ChrisTekam/thermobox/report/report.pdf

## Design and Implementation of an Arduino-Based

## Thermal PI Control System

## R. Khedoe, D. Sewratan, C. Tekam and D. Wartim

BSc. Electrical Engineering, FTeW, AdeKUS, Paramaribo, Suriname

## Abstract

Thermal control systems are widely used and have applications in semiconductor manufacturing and thermal power plants. However, thermal control systems are slow, limited by the actuator, and sensitive to disturbances. Recent work has attempted to solve these problems with PID simulations or complex algorithms. These approaches are valid, but quite complex. In contrast, this project regulates temperature inside a small foam box, utilizing MATLAB scripts and PI logic on Arduino. From the results, the setpoint is maintained, but the overshoot requirements are not achieved. The plant model cannot describe the system dynamics. Further analysis is needed to either tune the PI controller or accurately model the plant.

Index Terms - Thermal control, PI, MATLAB, Arduino

## I. Introduction

Thermal systems have many industrial applications, such as

semiconductor manufacturing and thermal power plants [1].

Therefore, thermal control is crucial for achieving accurate

measurements, maintaining production quality and optimizing

energy usage [2], [3]. However, thermal control systems also

face many challenges, such as disturbances, actuator limitations,

slow dynamics and delay [1], [4].

By designing a suitable controller, many of these issues are

addressed [4], [5]. For most (industrial) thermal processes,

Proportional Integral Derivative (PID) control is implemented,

but depending on the plant and objectives, PI control is sufficient

[5]. Previous studies implement PID thermal control only in

simulation or use a complex algorithm and plant, where Arduino

is exclusively used for data acquisition [6], [7], [8].

In contrast, this project aims to regulate the temperature at

a setpoint in a small foam box in both a Simulink model

and physical lab experiment. The closed-loop system uses an

Arduino Uno to implement PI-control and data acquisition, with

controller gains that are selected analytically. The design is

evaluated with frequency response theory (Nyquist and Bode) and tested on the physical system under disturbances. The

objective is to minimize the settling time and overshoot while

also rejecting disturbances.

## II. Methods

From the general block diagram for a control system (see fig. 1)

and the available components (see appendix A), design of the

system begins.

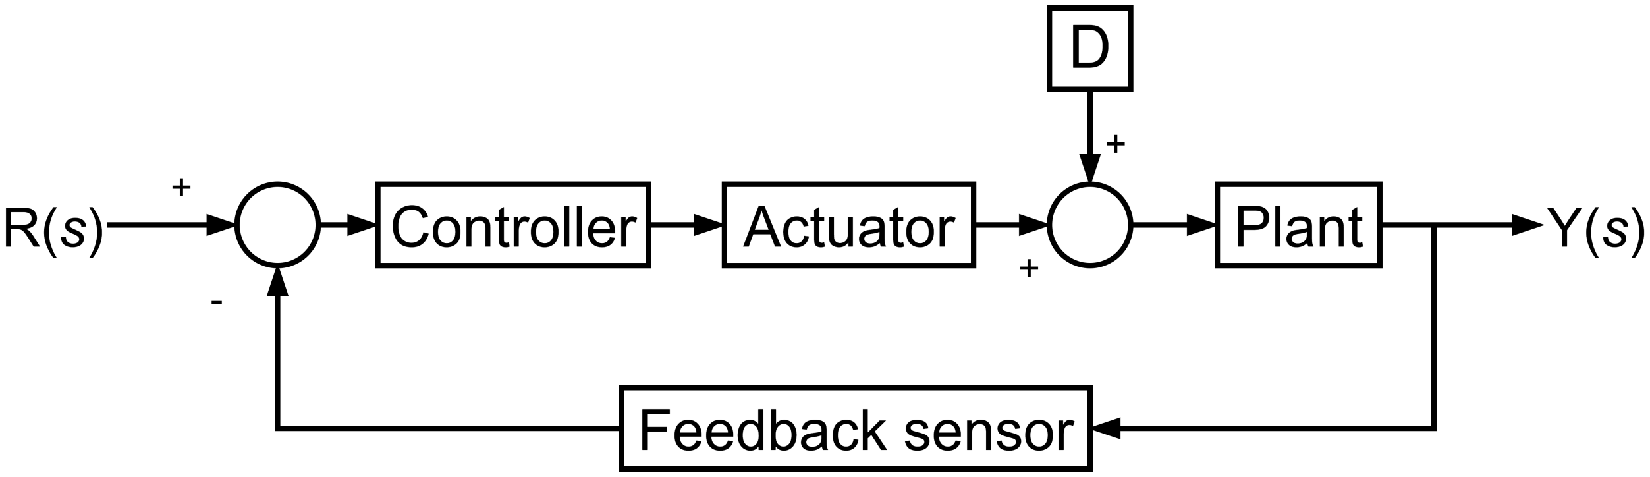
[picture p3: figure]

Figure 1: General block diagram for a control system.

The goals are to reduce settling time, overshoot and reject

disturbances; therefore it is necessary to choose and design

components appropriately (see table 1).

Table 1: System implementation.

Element | Implementation
Controller | PI logic on Arduino Uno
Actuator | Heater
Plant | Temperature inside the box
Feedback sensor | DS18B20 probe
Signal Conditioner Heater driver circuit

The heater system consists of the heater driver circuit and the

power resistor (see fig. B.1) and is located inside a small EPS

foam box. Assuming it is cube-shaped with an internal volume

of 500 mL, wall thickness t = 2 cm, and thermal conductivity κ = 0.033 W m⁻¹ K

−1
[10], the plant transfer function is

Gp (s) =

θ(s)

D(s)

=

V

2
s
R

Rth

RthCths + 1

=

96.7
283s + 1

(1)

See appendix C for the derivation.

The block diagram for the thermal control system is shown in

fig. 2.

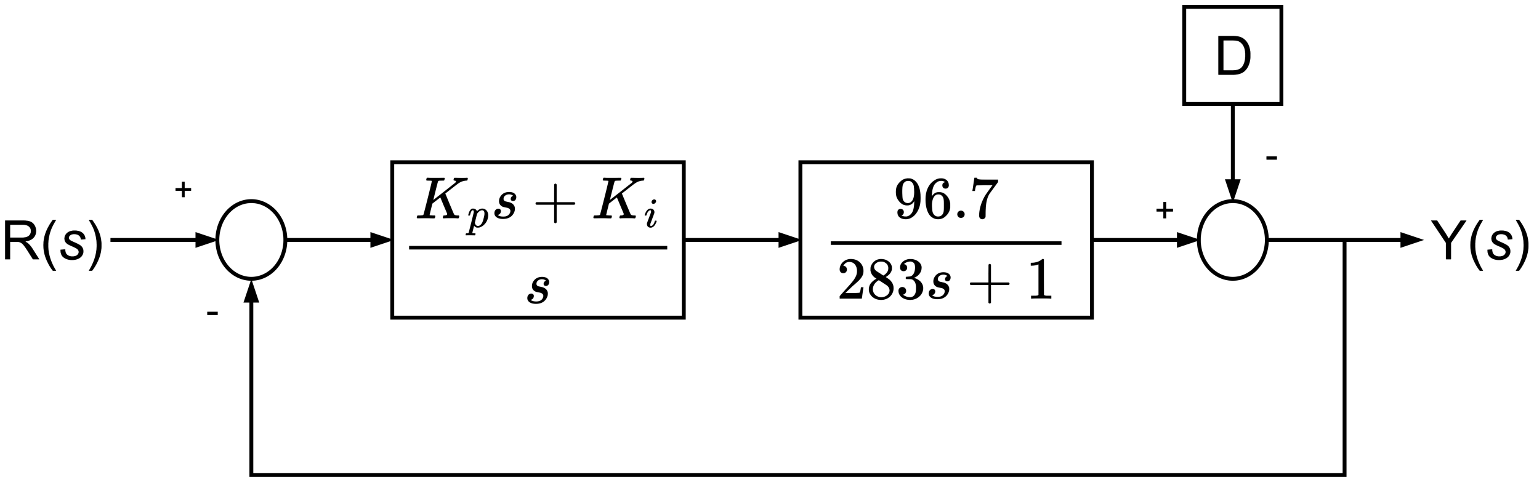
[picture p4: figure]

Figure 2: Thermal control system block diagram.

And this corresponds with

CLTF =

96.7(Kps + Ki)
283s

2 + (1 + 96.7Kp)s + 96.7Ki

=

0.342(Kps + Ki)

s

2 + (0.0035 + 0.342Kp)s + 0.342Ki

(2)

Utilizing MATLAB/Simulink and the frequency response the-

ory, system stability and performance is evaluated, before lab

tests begin. Figure 3 and 4 illustrate the Simulink model and

the system schematic diagram (in lab), respectively.

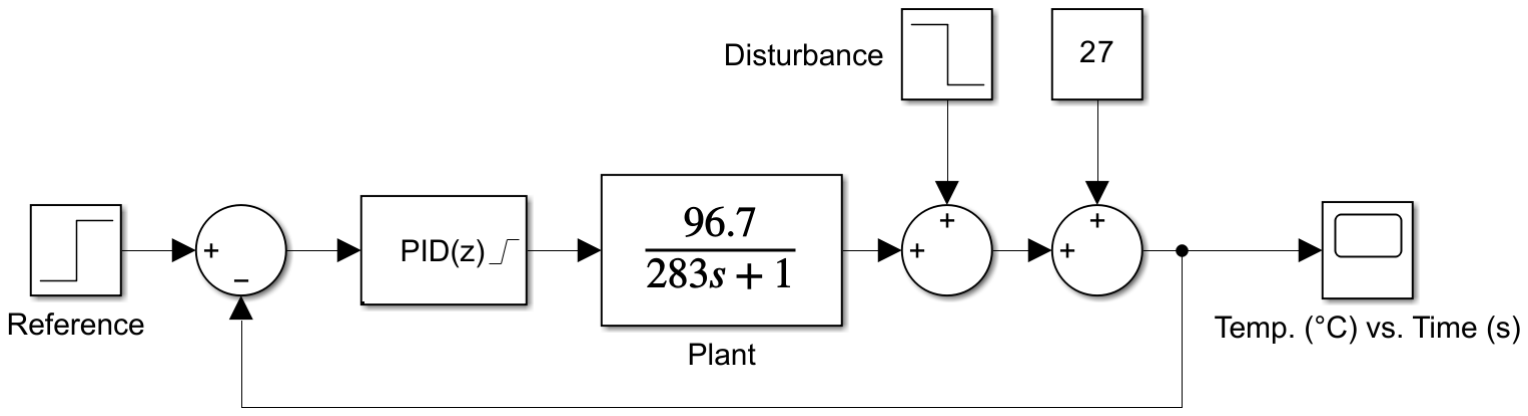
[picture p5: figure]

Figure 3: Simulink model.

The ‘27’ block adds an offset, ensuring the temperature rise starts

from the ambient temperature. Furthermore, unity feedback

is assumed, as the probe measures and responds much quicker

compared to the rise in the box [9].

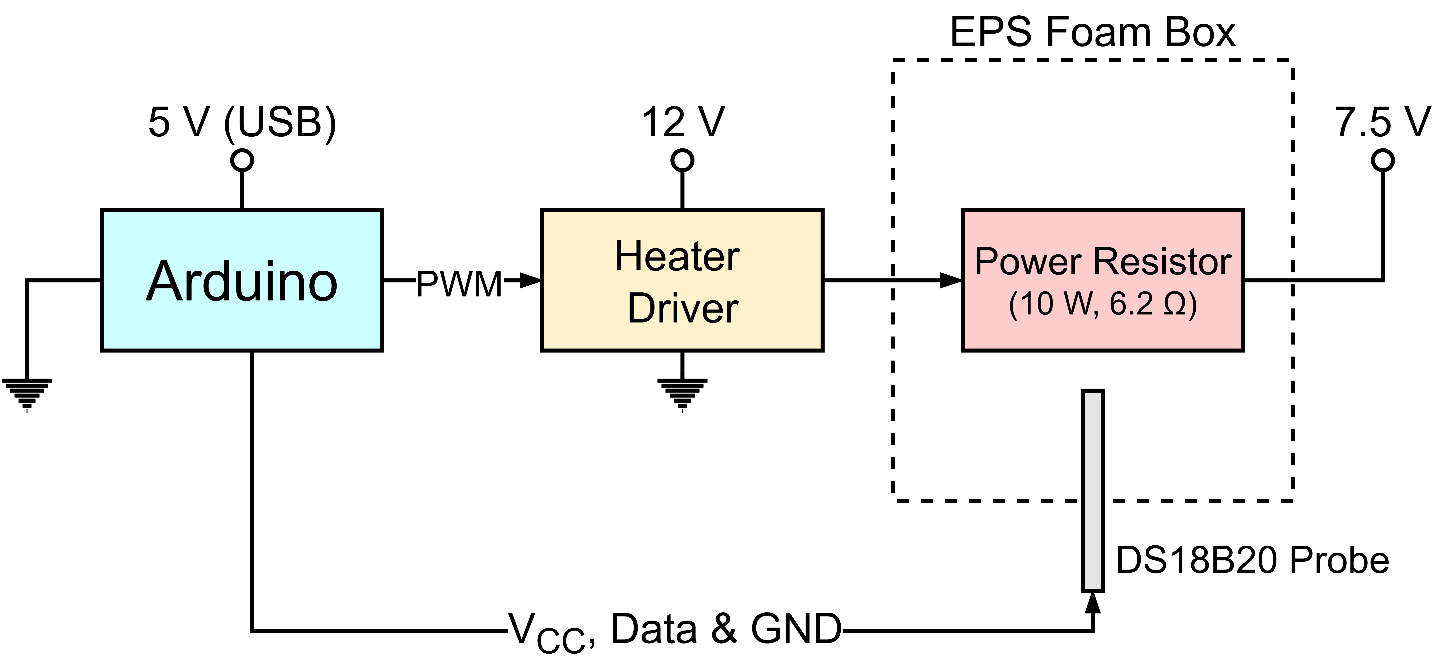
[picture p6: figure]

Figure 4: In lab system diagram.

By conducting open-loop tests in lab and making use of a

function fit script, the ‘real’ plant transfer function can be

approximated. Furthermore, closed-loop tests can reveal the

effectiveness of K-values derived from calculations and sim-

ulations. MATLAB scripts can be utilized to find K-values

when calculations become tricky, using the frequency response

tuning method. That is, finding ζ from the %OS requirements and increasing the frequency of Ki
Kp

such that the desired PM is obtained. Lastly, varying Kp until |L( jω)| reaches 0 dB.

## III. Results

The Routh-Hurwitz method gives absolute stability ranges

Kp > −0.01 and Ki > 0. For a settling timeTs = 10 min = 600 s

and overshoot %OS ≤ 2 %, exact K-values are found:

Ts =

4
ζωn

=⇒ ζωn =

4

Ts

ζωn =

4
600

= 0.006667 rad s⁻¹

(3)

ζ =

vuuuut ln²
%OS

100

π

2 + ln²

%OS

100

=

vuuuut ln²
2

100

π

2 + ln²

2

100 ≈ 0.7797

(4)

Choose ζ = 0.8 > 0.7797. So ωn = 0.008334 rad s⁻¹ . Com-

parison of Eq. (2) with the

2nd Order Prototype:

ω

2
n

s

2 + 2ζωns + ω

2
n
, | (5)

yields Kp = 0.028754 and Ki = 0.000203. Figure 5, 6, 7, and

8 show the corresponding pole and zero locations, Nyquist plot,

Bode plot and simulated time response.

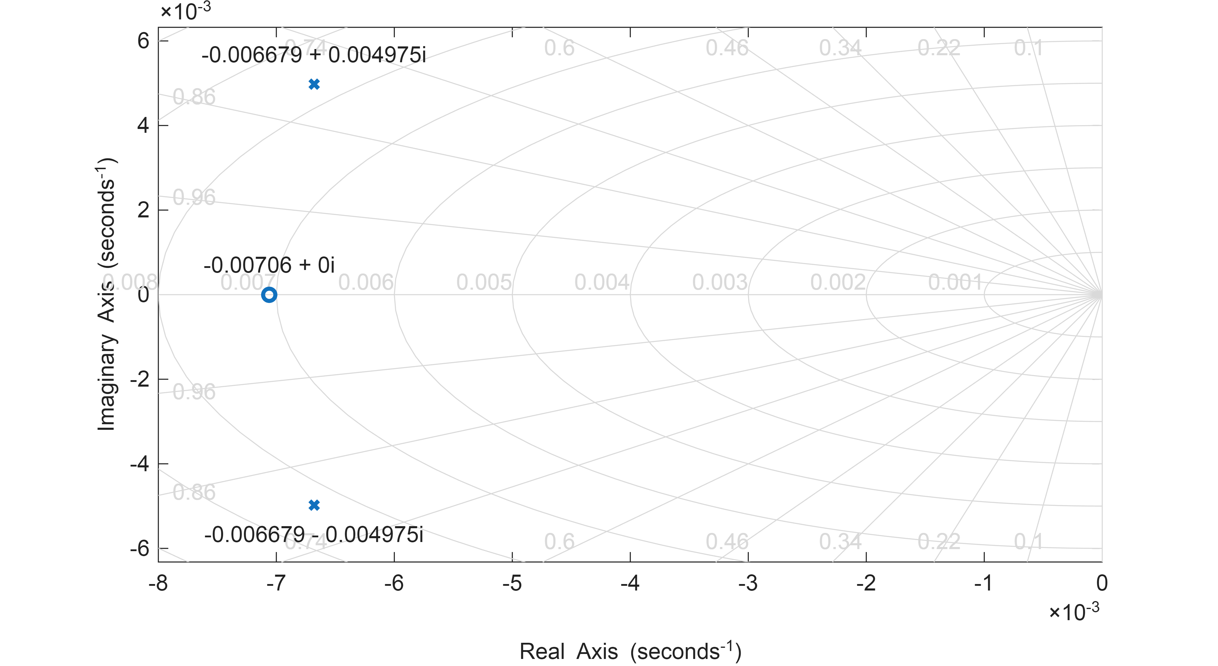
[picture p7: figure]

Figure 5: Locations of system poles and zeros.

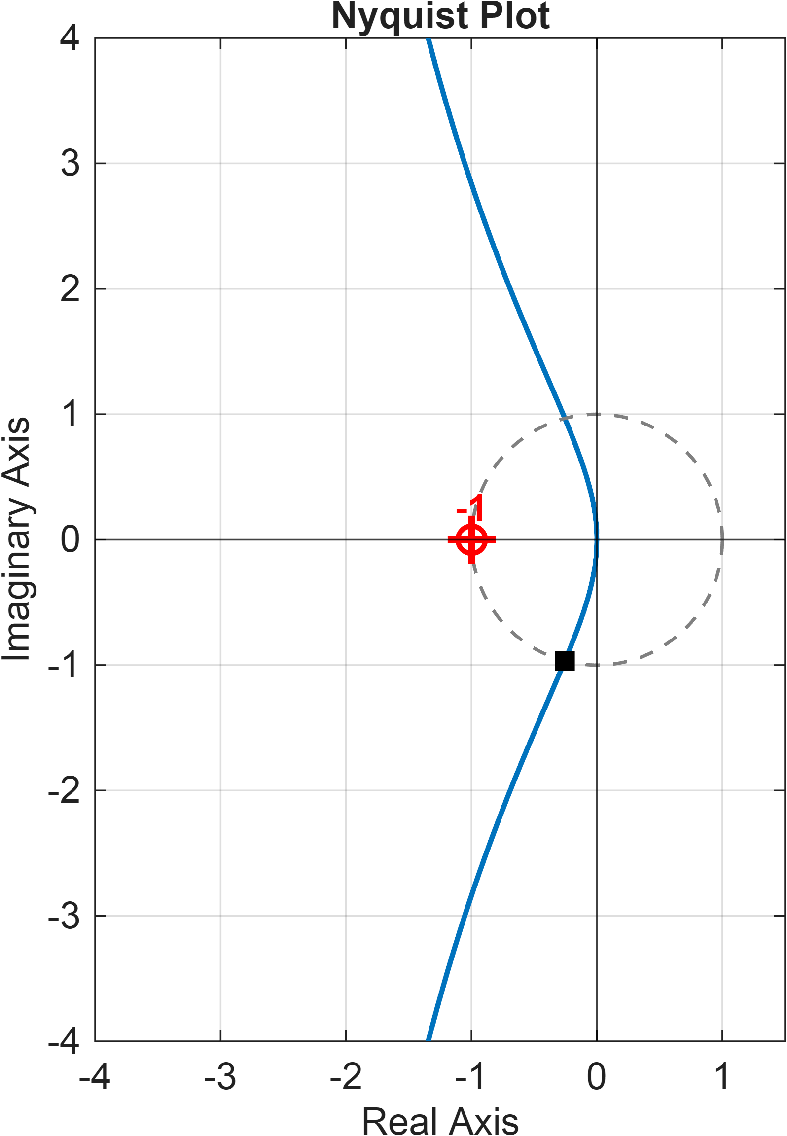
[picture p8: figure]

Figure 6: System Nyquist plot from 10⁻⁶ to 10⁶

rad s⁻¹

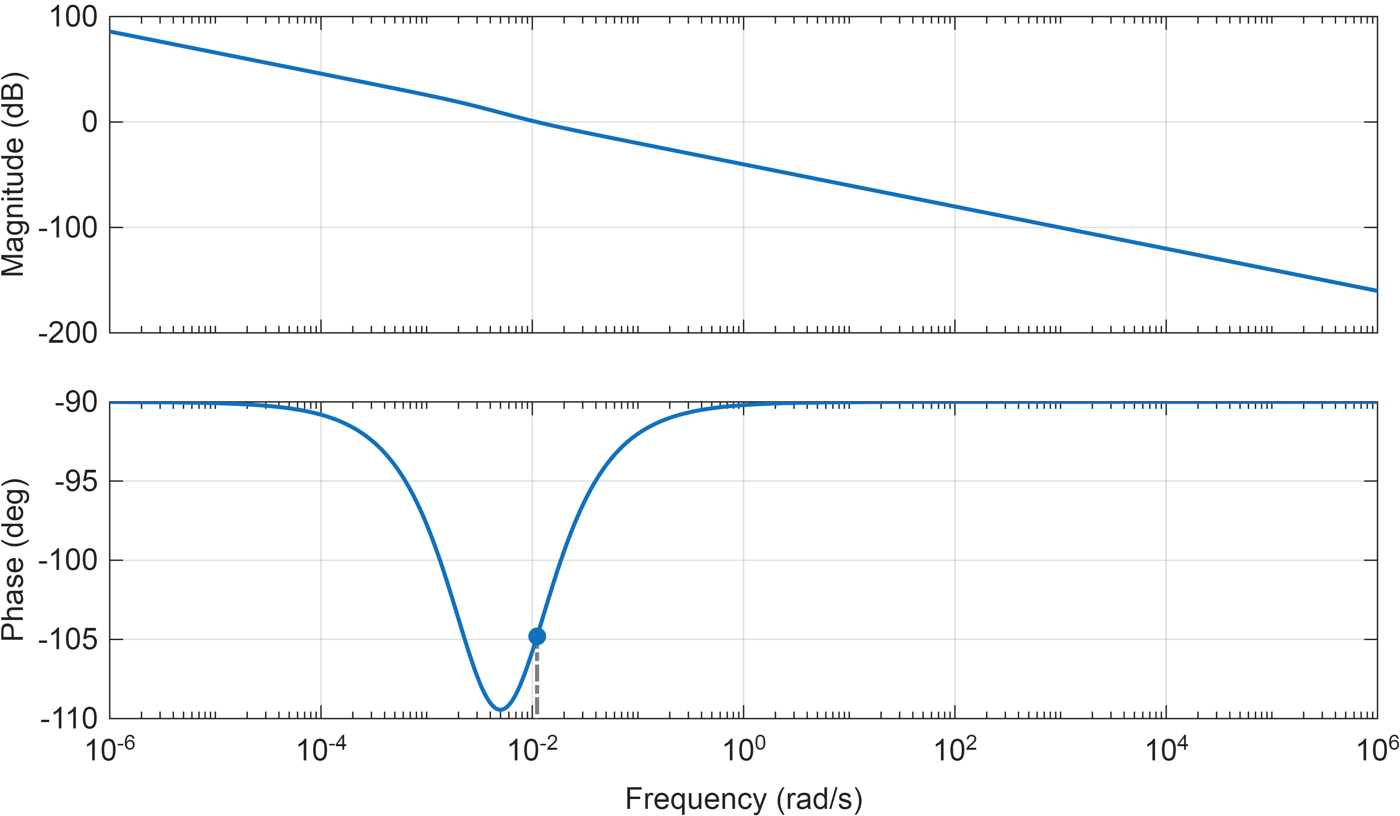
[picture p9: figure]

Figure 7: System Bode plot with phase margin indicated.

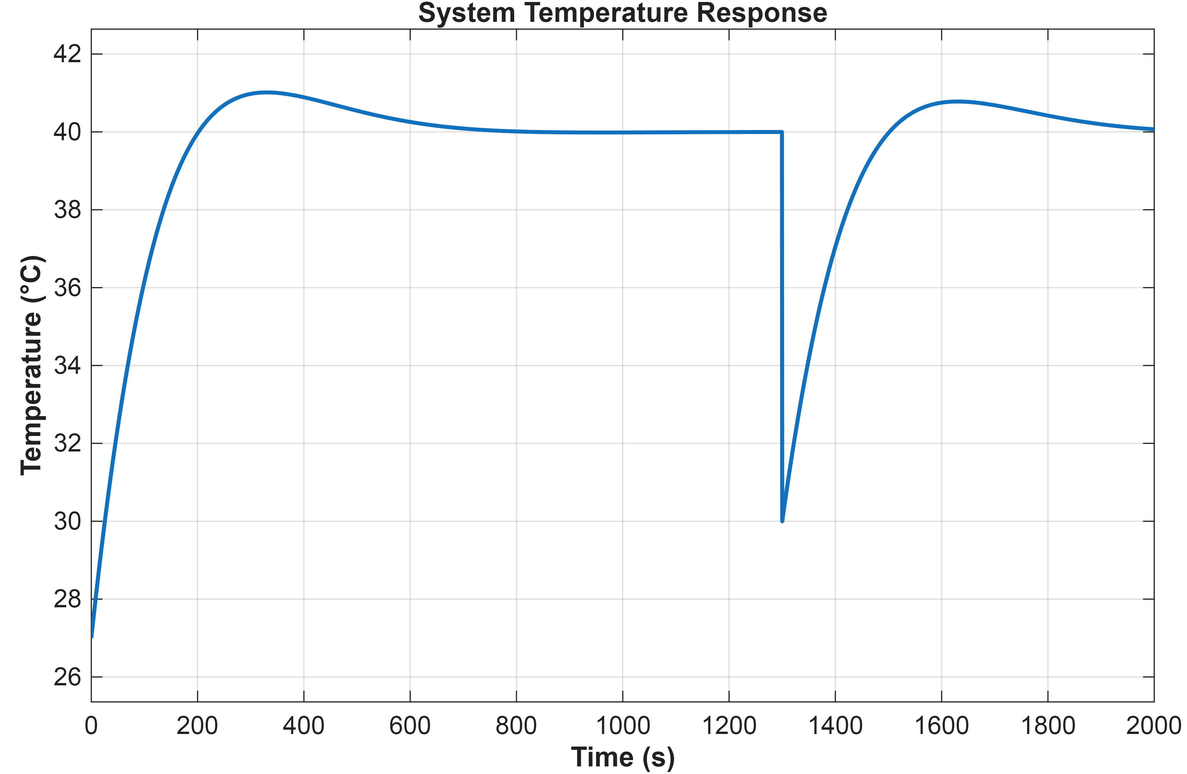
[picture p10: figure]

Figure 8: Time response with disturbance at 1300 s.

For Kp = 0.028754 and Ki = 0.000203 the system seemingly

remains stable for all frequencies and loop gain values, as the

-1 point stays on the left of the line (see fig. 6) and the gain

margin (GM) is infinite (see fig. 7; the phase plot never reaches −180◦
). The phase margin (PM) is 75.2

◦
at crossover frequency
ωc = 0.0111 rad s⁻¹
. Furthermore, the system reaches the setpoint (40 ◦C) in roughly 600 s with an maximum overshoot

of 0.8

◦C and it rejects the disturbance, a −10 ◦C drop.

However, at the hardware test, the system fails to maintain the setpoint. In fact, it increases beyond 40 ◦C. The test was

therefore stopped after around 12 min. Figure 9 illustrates this.

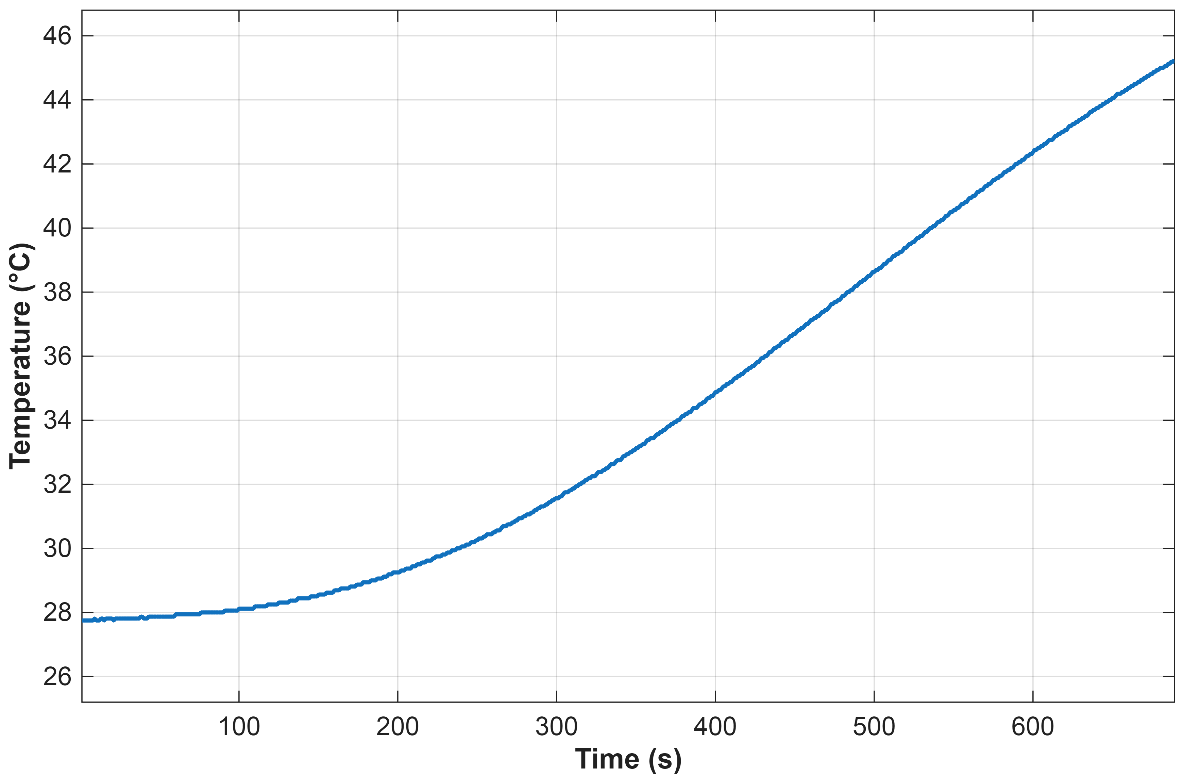
[picture p11: figure]

Figure 9: Closed-loop time response in lab.

The results of the open-loop test are shown in fig. 10. Note that the power was cut off once the target of 40 ◦C had been reached.

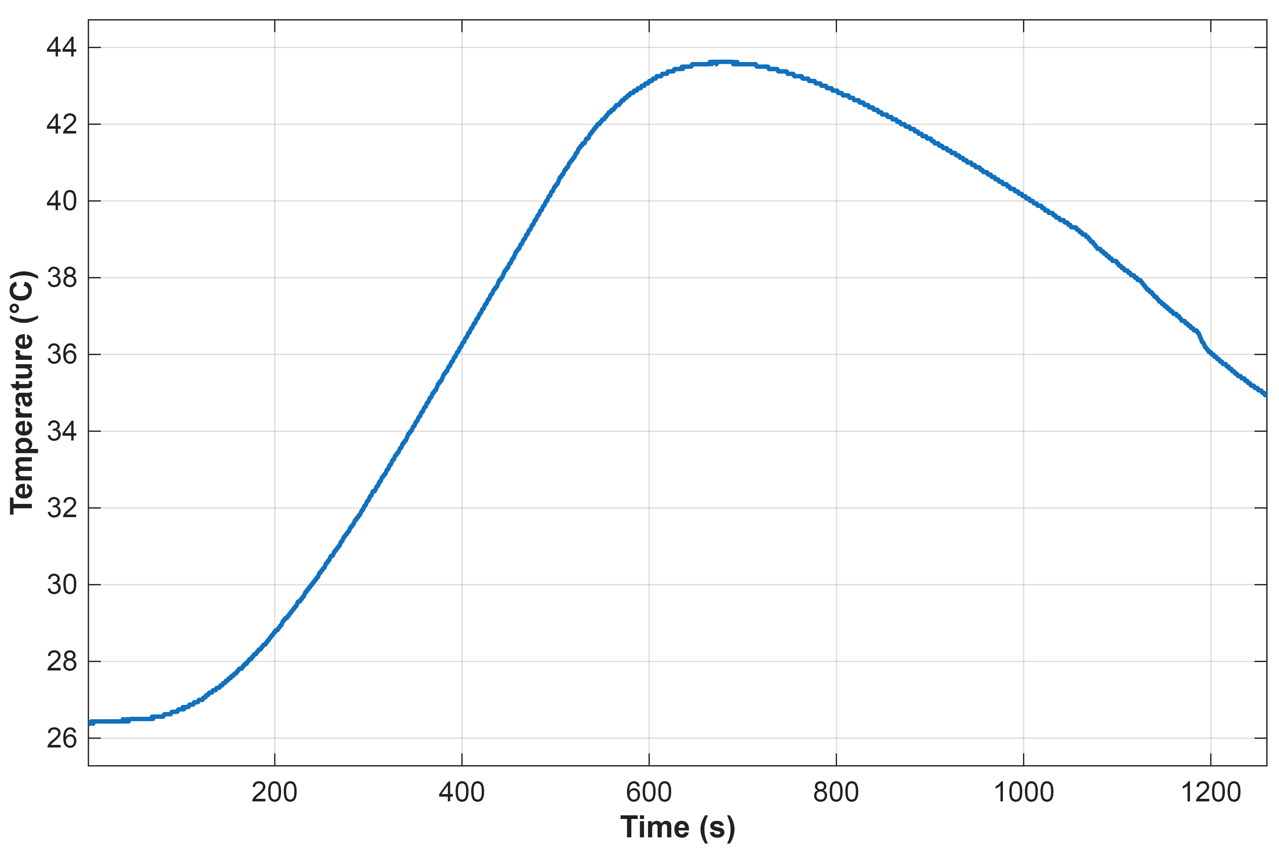
[picture p12: figure]

Figure 10: Open-loop time response of system.

The function fitted from the response is

Gp =

38.7
125316s

2 + 708s + 1

(6)

As the characteristic equation (CE) of the CLTF becomes a third-

order equation, Kp and Ki were determined using a frequency

response tuning script. The method gives Kp = 0.02 and

Ki = 0.00004. Figure 11, 12, and 13 show the corresponding

Bode plot, Nyquist plot and simulated time response.

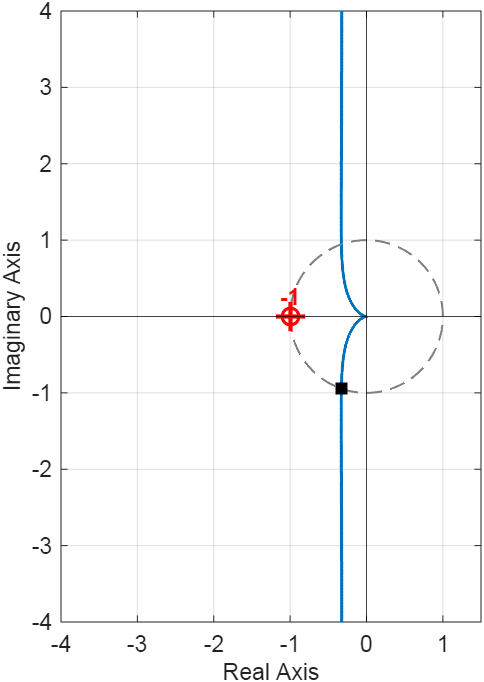
[picture p13: figure]

Figure 11: Nyquist plot of new plant.

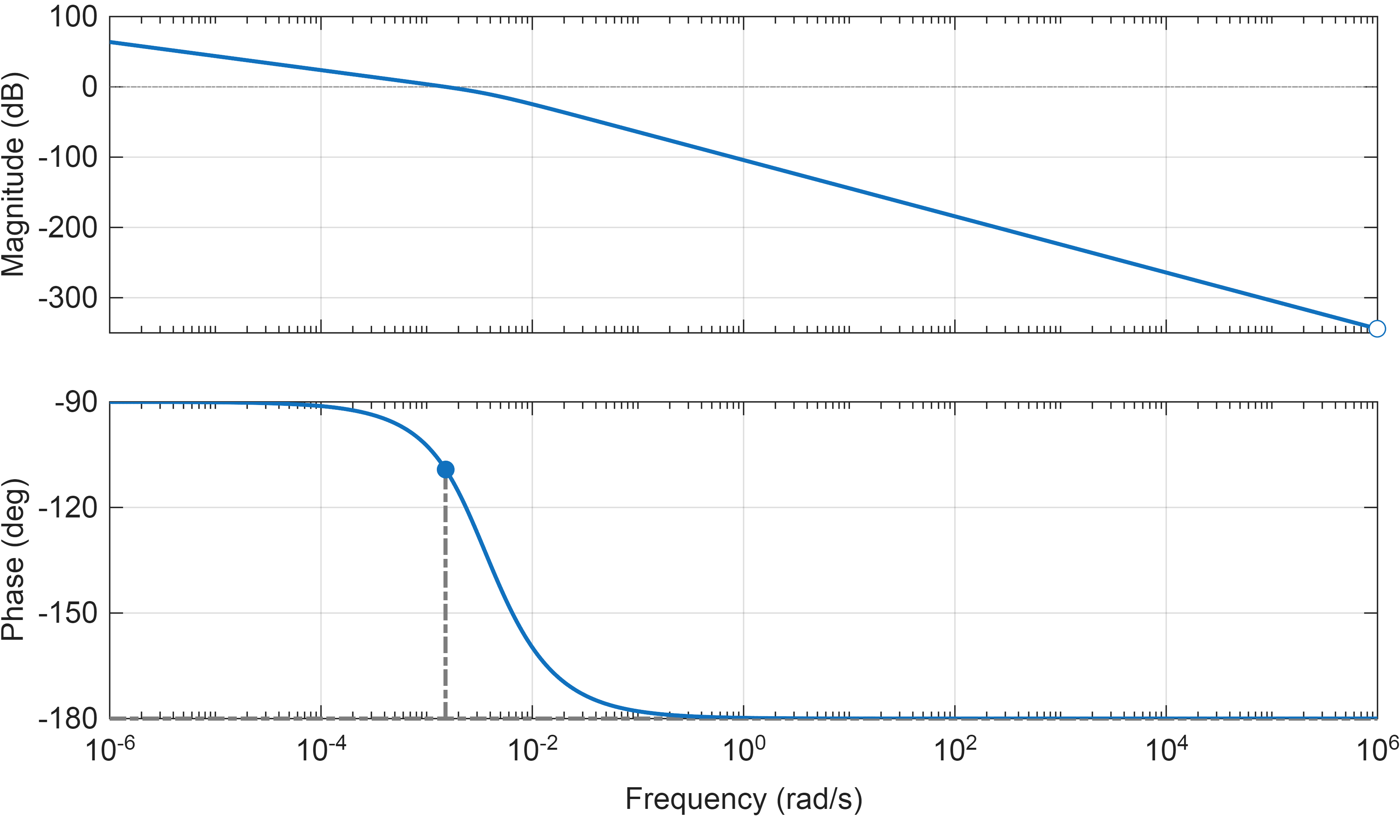
[picture p14: figure]

Figure 12: Bode plot of new plant with PM indicated.

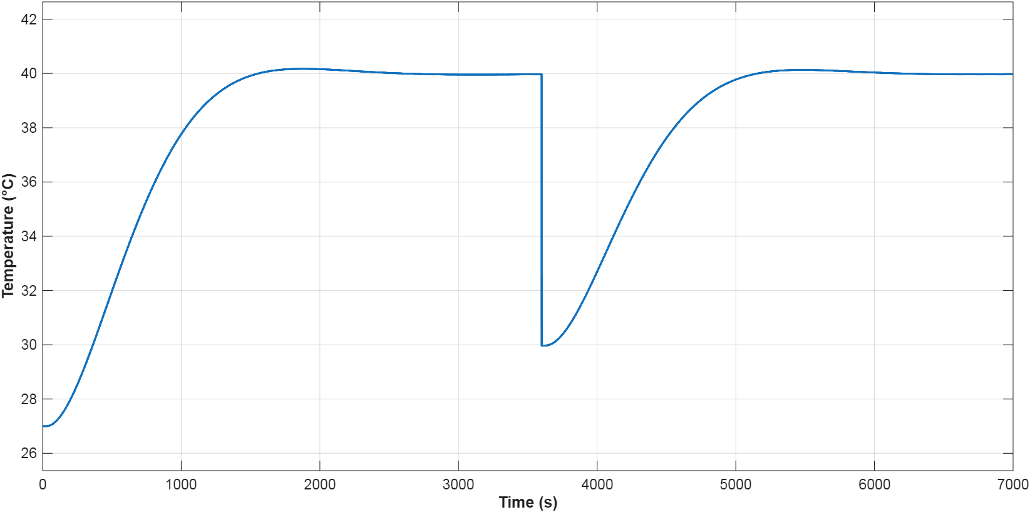
[picture p15: figure]

Figure 13: Simulated time response of new plant with disturbance at 3600 s.

Similar to the previous results, the system remains stable for all frequencies from 10⁻⁶
to 10⁶

rad s⁻¹
and gain values because

the -1 point is located to the left at all times and GM = ∞.

Furthermore, PM = 70.8

◦

at ωc = 0.00151 rad s⁻¹
. Although

the system can reject disturbances, it is very slow and takes

roughly 1500 s to reach the setpoint.

Figure 14 shows the closed-loop time response of the system

with the fitted plant in lab for Kp = 0.02 and Ki = 0.00004.

The test shows that the system is unable to reject the disturbance

effectively; the overshoot is higher.

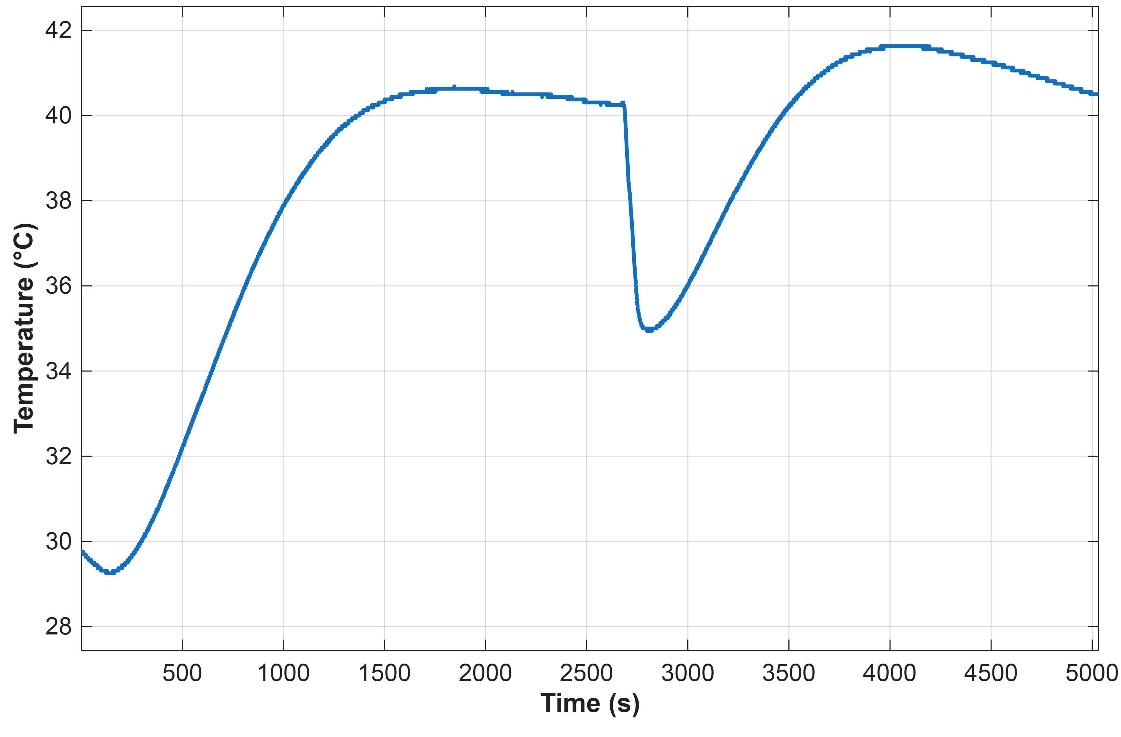
[picture p16: figure]

Figure 14: Closed-loop time response of system in lab.

## IV. Discussion

The first-order plant was modeled with many approximations

and assumptions, so the closed-loop results were expected.

The closed-loop time response of the system with the fitted

plant model performed according to expectations, with the

exception of disturbance rejection. The Nyquist plot shows that

the thermal system is stable. Regarding the Bode plots, in both cases, GM = ∞ and PM = 70◦

- 75◦

for ω ∈ [10⁻⁶
, 10⁶
].

## V. Conclusion

The thermal PI control system was tuned, simulated, tested

and evaluated using the described methods. According to the

results, simulation and lab tests perform similarly in time but

differ in overshoot. The system dynamics cannot be accurately

described by the current plant model. Further analysis is needed to model the plant, so that disturbances are rejected within the

overshoot requirements. Another possibility is conducting

closed-loop tests to better tune the controller.

## A. List of Materials

Table A.1 and A.2 list the applied components and instruments

and is based on availability (at the time).

Table A.1: Applied components.

Component | Amount Use
Resistors | 3 | Pull-up, pull-down and
| | current-limiting resistors.
IRF44ZN MOSFET | 1 | Part of heater driver.
2N3904 BJT | 1 | Driving the gate of the
| | MOSFET.
DS18B20 probe | 1 | Feedback sensor.
Power resistor | 1 | Functions as plant.
Arduino Uno | 1 | Programmed with PI
| | control logic.
EPS foam box | 1 | Closed, insulated
| | environment.

Table A.2: Required instruments.

Instrument | Amount Use
Digital multimeter | 1 | Checking voltages and
| | resistor values.
DC source | 1 | Supplying the heater with
| | voltage.

## B. Heater System

The heater driver circuit is necessary because the Arduino is

unable to deliver enough current.

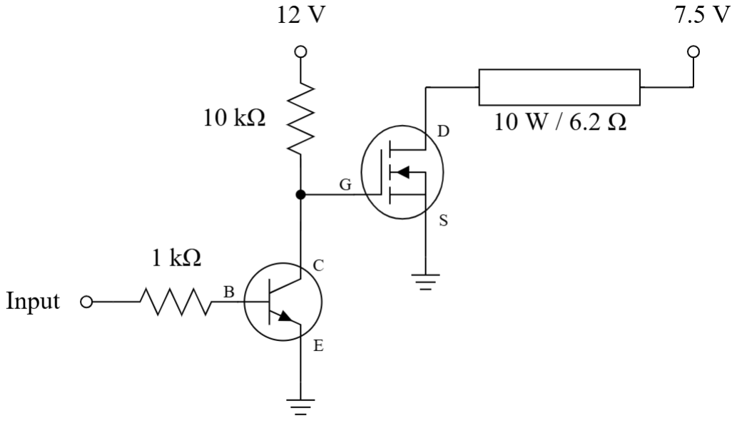
[picture p17: figure]

Figure B.1: Heater circuit.

If a PWM signal is sent through, the MOSFET saturates and the

drain is pulled to ground, so current flows through the power

resistor, thereby producing heat. The heater will switch on and

off depending on the duty cycle D.

## C. Derivation of Plant

The plant is modeled as a first-order system with heater duty

cycle as the input and temperature rise as the output. The air,

the heater resistor and the inner foam is treated as one body

at a temperature T. Another assumption is that there are no

leaks, so heat escapes only by conduction through the walls. A

lot of other assumptions were made in order to approximate

a (somewhat) realistic first-order thermal plant and reduce

complexity.

Let Cth be the thermal capacitance of everything inside the box,

Rth the thermal resistance, Pin the heater power and Tamb the

(constant) ambient temperature. Then

Cth

dT

dt

= Pin (t) − T (t) − Tamb

Rth

. | (C.1)
With temperature rise θ(t) = T (t)−Tamb, this becomesCth | d θ dt +

θ
Rth

= Pin (t). Taking the Laplace transform (with zero initial

conditions) gives

θ(s)

Pin (s)

=

Rth

RthCth s + 1

. | (C.2)

The heater is a power resistor (R = 6.2 Ω) driven by PWM from

a supply Vs = 7.5 V. The average power is given by

Pin = D

V

2
s
R
, | (C.3)
where D | ∈ [0, 1]. | The maximum power is Pmax | =

(7.5)

2
/6.2 ≈ 9.07 W (safely below the resistor’s max. of 10 W).

The plant from duty cycle to temperature rise is therefore

Gp (s) =

θ(s)

D(s)

=

K

τs + 1

, | (C.4)

with

K =

V

2
s
R

Rth,

τ = RthCth.

| (C.5)

Assuming the foam box is a cube with an inside volume of

500 mL, the inner side length is a = 0.0794 m and inner surface area Ain = 0.0378 m²
. With an assumed wall thickness

t = 2 cm, the outer side length is aout = 0.1194 m and the outer area Aout = 0.0855 m²
. The average area is Aeff =
√
AinAout = 0.0568 m²
. And with the EPS thermal conductivity κ = 0.033 W m⁻¹ K

−1
[10],

Rth =

t

κAeff

=

0.02
0.033 × 0.0568 = 10.66 ◦C W⁻¹

(C.6)

Working with the average (effective) area gives a value that is a

better approximation than just using Ain or Aout.

Cth is the sum of the parts inside the box. The air con-

tributes Cair = ρaircairV = 0.6 J ◦C

−1
. The EPS walls (assumed ρ = 25 kg m⁻³

, c = 1300 J kg⁻¹ K
−1
[10], wall volume
1.201 × 10⁻³ m³
) have a mass of 30 g, so a full capacitance of 39 J ◦C

−1
. However for just the inside part of the box,

Cwall = 19.5 J ◦C

−1
. The resistor is assumed to have a mass of 8 g and c = 800 J kg⁻¹ K
−1

, giving Cres = 6.4 J ◦C

−1
. The

total is
Cth = 0.6 + 19.5 + 6.4

= 26.5 J ◦C

−1

(C.7)

The model parameters are

K = 9.07 × 10.66 ≈ 96.7

◦C per unit duty,

τ = 10.66 × 26.5 ≈ 283 s,

(C.8)

so this means

Gp (s) =

θ(s)

D(s)

=

96.7
283s + 1
. | (C.9)

Gp is a decent starting point for the ‘real’ transfer function of

the plant, as this model neglects the effects of the temperature

balance between the air and the foam box. In reality, the box

has leaks and Cth cannot be added together.

## D. List of Symbols

Table D.1: Symbol list.

Symbol | Meaning | Unit
t | Wall thickness | m
κ | Thermal conductivity of EPS | W m⁻¹ K

−1
Gp (s) | Plant transfer function | ◦C
θ | Temperature rise | ◦C
D | Heater duty cycle | –
Vs | Heater supply voltage | V
R | Power resistor resistance | Ω
Rth | Thermal resistance of the box
| walls | ◦C W⁻¹
Cth | Total thermal capacitance inside
| the box | J ◦C −1
Kp | Proportional gain | ◦C −1
Ki | Integral gain | ◦C −1 s −1
Ts | Settling time | s
%OS | Percent overshoot | %
ζ | Damping ratio | –
ωn | Natural frequency | rad s⁻¹
GM | Gain margin | dB
PM | Phase margin | ◦
ωc | Gain crossover frequency | rad s⁻¹
L( j ω) | Open-loop (loop) transfer
| function | dB
T | Temperature inside the box | ◦C
Pin | Average heater power | W
Tamb | Ambient temperature | ◦C
Pmax | Maximum heater power | W
K | Plant gain | ◦C
τ | Plant time constant | s
a, aout | Inner and outer side length | m
Ain, Aout | Inner and outer surface area | m²
Aeff | Effective (average) wall area | m²

Cair | Thermal capacitance of the air | J ◦C −1
ρ | Density | kg m⁻³
c | Specific heat capacity | J kg⁻¹ K −1
V | Internal volume of the box | m³
Cwall | Thermal capacitance of the
| inner foam wall | J ◦C −1
Cres | Thermal capacitance of the
| heater | J ◦C −1

## E. Additional Information

For more information or to view the code and supplementary

documentation, visit the GitHub repository by clicking here. (https://github.com/ChrisTekam/thermobox)

## References

[1] “Model-based analysis of an industrial PLC-controlled dead-

time thermal system,” Case Studies in Thermal Engineer-

ing, 2026, Accessed: 2026-10-3, issn: 2214-157X. Link:

https : / / www . sciencedirect . com / science / article / pii /

S2214157X2600986X (https://www.sciencedirect.com/science/article/pii/S2214157X2600986X)

[2] Arroyo Instruments, Temperature control fundamentals: Stabil-

ity, accuracy, and noise - part 1, Accessed: 2026-09-30, 2026.

Link: https://www.arroyoinstruments.com/blog/temperature-

control-fundamentals-stability-accuracy-and-noise-part-1/ (https://www.arroyoinstruments.com/blog/temperature-control-fundamentals-stability-accuracy-and-noise-part-1/)

[3] Organomation, Understanding the importance of temperature

control in laboratories and industrial processes, Accessed:

2026-10-04, 2026. Link: https:// www. organomation. com/

understanding - the - importance - of - temperature - control - in -

laboratories-and-industrial-processes (https://www.organomation.com/understanding-the-importance-of-temperature-control-in-laboratories-and-industrial-processes)

[4] “Process control and thermal engineering studies,” Processes,

vol. 14, no. 20, p. 3233, 2026, Accessed: 2026-10-02. doi:

10. 3390/ pr14203233 (https://doi.org/10.3390/pr14203233) Link: https://www.mdpi.com/ 2227 -

9717/14/20/3233 (https://www.mdpi.com/2227-9717/14/20/3233)

[5] AIP Publishing, “Comparative analysis of proportional-

proportional control systems,” Physics of Fluids, vol. 36, no. 8,

p. 083 625, 2024, Accessed: 2026-10-13. doi: 10 . 1063 / 5 .

0210000 (https://doi.org/10.1063/5.0210000) Link: https://pubs.aip.org/aip/pof/article-abstract/

36/8/083625/3310156/Comparative-analysis-of-proportional-

proportional (https://pubs.aip.org/aip/pof/article-abstract/36/8/083625/3310156/Comparative-analysis-of-proportional-proportional)

[6] “Thermal management inside a discretely heated rectangular

cuboid using P, PI and PID controllers,” Case Studies in Thermal

Engineering, 2023, Accessed: 2026-10-15, issn: 2214-157X.

Link: https:// www. sciencedirect . com/ science/ article/ pii/

S2214157X23009073 (https://www.sciencedirect.com/science/article/pii/S2214157X23009073)

[7] “Thermal investigation of a thermoelectric cooler based on

arduino and PID control approach,” Case Studies in Thermal

Engineering, 2022, Accessed: 2026-10-18, issn: 2214-157X.

Link: https:// www. sciencedirect . com/ science/ article/ pii/

S2214157X22004956 (https://www.sciencedirect.com/science/article/pii/S2214157X22004956)

[8] “Gudermannian-based error-shaped PID controller tuned via

THRO for nonlinear CSTR temperature controls,” Chaos, Soli-

tons & Fractals, 2026, Accessed: 2026-10-12, issn: 0960-0779.

Link: https:// www. sciencedirect . com/ science/ article/ pii/

S0960077926005242 (https://www.sciencedirect.com/science/article/pii/S0960077926005242)

[9] “Evaluating suitability of a DS18B20 temperature sensor for

use in an accurate air temperature distribution measurement

network,” Engineering Proceedings, vol. 10, no. 1, p. 56, 2026,

Accessed: 2026-10-06. doi: 10.3390/engproc2026010056 (https://doi.org/10.3390/engproc2026010056) Link:

https://www.mdpi.com/2673-4591/10/1/56

[10] W. M. Haynes, Ed., CRC Handbook of Chemistry and Physics,

97th. Boca Raton, FL: CRC Press, 2016, isbn: 978-1498754286.
