ChrisTekam/thermobox/docs/plant_derivation_500_ml.pdf

## Plant Transfer Function of the Foam-Box Heater

500 mL cube, 2 cm EPS walls

Thermal Control System project

## 1 Goal and assumptions

The goal is to derive a first-order transfer function from heater duty cycle to temperature rise inside the box, starting from the energy balance.

- The box is a cube with an inside volume of V = 500 mL = 5 × 10⁻⁴ m³
- The wall thickness is t = 2 cm and the thermal conductivity is κ = 0.033W m⁻¹K⁻¹
- The heater is a Rheater = 6.2 Ω resistor driven by PWM from a supply of Vs = 7.5 V.
- The air, the resistor and the inner foam are lumped into one body at a single temperature T.
- The box has no leaks (lid gaps, wire feedthroughs), and heat leaves only by conduction through the walls.

## 2 Energy balance

Let Cth be the thermal capacitance of the lumped body, Rth the thermal resistance to the room, Pin the heater power and Tamb the ambient temperature:

Cth

dT
dt = Pin(t) −

T(t) − Tamb

Rth

. | (1)

Define the temperature rise θ(t) = T(t) − Tamb. Because Tamb is constant, dθ/dt = dT /dt, so

Cth

dθ
dt +

θ

Rth

= Pin(t). | (2)

Taking the Laplace transform with zero initial conditions gives
Cths +

1

Rth
θ(s) = Pin(s) =⇒

θ(s)
Pin(s)

=

Rth
RthCth s + 1
. | (3)

## 3 Heater input

The Arduino commands a duty cycle D ∈ [0, 1]. At 1 kHz or any PWM frequency far above the thermal bandwidth, only the average power matters:

Pin = D

V

2
s
Rheater

, Pmax =

7.5

2

6.2

| | = 9.07W. | | (4)

The plant from duty cycle to temperature rise is therefore G(s) = θ(s)
D(s)
| =

(V

| 2 s /Rheater) Rth
| RthCth s + 1 | = K τs + 1
| | , | | (5)

with

K =

V

2
s
Rheater
Rth | [°C per unit duty], | τ = RthCth | [s]. | (6)

## 4 Geometry

The side length of the inside cube and its surface area are

a =

√3
V =

p3
5 × 10⁻⁴ = 0.0794 m, Ain = 6a

2 = 0.0378 m²
. | (7)

With t = 2 cm, the outside cube has

aout = a + 2t = 0.1194 m, Aout = 6a

2

out = 0.0855 m²
. | (8)

## 5 Thermal resistance

Heat conducts through a hollow shell whose area grows from the inside surface to the outside surface. A simple representative area is the geometric mean:

Aef f =

p
Ain Aout = 0.0568 m²
| . | (9)

The conduction resistance of the wall is

Rth =

t

κ Aef f

=

0.02
0.033 × 0.0568
| = 10.66 °C/W. | (10)

For comparison, using Ain alone gives 16.0 °C/W and using Aout alone gives 7.1 °C/W, so Aef f sits between the two bounds.

## 6 Thermal capacitance

The capacitance is the sum of the parts that follow the inside temperature.

Air. With ρair = 1.2 kg/m³ and cair = 1005 J/(kg K):

Cair = ρair cair V = 1.2 × 1005 × 5 × 10⁻⁴ = 0.60 J/°C. | (11)

Foam walls. The wall volume is Vwall = a

3 out−a | 3 = 1.201×10⁻³ m³
. For expanded polystyrene I assume ρEP S = 25 kg/m³ and cEP S = 1300 J/(kg K):
mwall = 25 × 1.201 × 10⁻³ = 30.0 g, | Cwall = 0.0300 × 1300 = 39.0 J/°C. | (12)

The wall has a roughly linear temperature profile between the inside temperature and the room temperature, so on average it stores about half the heat it would store if it were entirely at the inside temperature. The effective wall capacitance is

Cwall,ef f =

1

2 Cwall = 19.5 J/°C. | (13)

Resistor. I assume a mass of 8 g and c = 800 J/(kg K):

Cres = 0.008 × 800 = 6.4 J/°C. | (14)

Part | C (J/°C)
Air | 0.60
Foam walls (effective) | 19.5
Resistor | 6.4
Total Cth | 26.5

Table 1: Thermal capacitance budget.

## 7 Result

K = 9.07 × 10.66 = 96.7 °C per unit duty, | τ = 10.66 × 26.5 = 283 s, | (15)

so
G(s) = θ(s)
D(s)

≈

96.7
283 s + 1

or per watt:

θ(s)
Pin(s)

≈

10.66
283 s + 1
. | (16)

In absolute temperature the output is
T(t) = Tamb + θ(t), | Tamb ≈ 25 °C. | (17)

The transfer function itself does not depend on the ambient temperature, because it describes the rise above ambient.

### 7.1 Duty cycle needed for a target temperature

At steady state θss = K Dss, so

Dss =

Ttarget − Tamb
K
. | (18)

For a 50 °C target, Dss = 25/96.7 ≈ 26%. Full duty would aim for a rise of about 97 °C, which is far above what EPS foam tolerates, so the duty cycle should be limited in both the simulation and the Arduino code.

### 7.2 Effect of the outside air film

The conduction-only model neglects the convective film on the outside of the box. With a typical combined coefficient h ≈ 8W/(m²K):

Rf ilm =

1

h Aout

=

1
8 × 0.0855
= 1.46 °C/W, | (19)

which gives Rth = 12.12 °C/W, K ≈ 110 and τ ≈ 321 s. The result is therefore best quoted as K ≈ 97–110 and τ ≈ 280–320 s.

## 8 Limitations

- The model is a single node. In reality the resistor body runs hotter than the air.
- Leaks reduce Rth and therefore K and τ .
- The foam density, specific heat and the resistor mass are estimates.
- The DS18B20 sensor lag is not included here; it adds a second first-order factor 1/(τss+ 1) in the feedback path.
- A measured open-loop step response (fixed duty, logged temperature) should be used to confirm K and τ : K is the final rise divided by the duty, and τ is the time to reach 63% of the final rise.
