ChrisTekam/thermobox/docs/finding_k-values.pdf

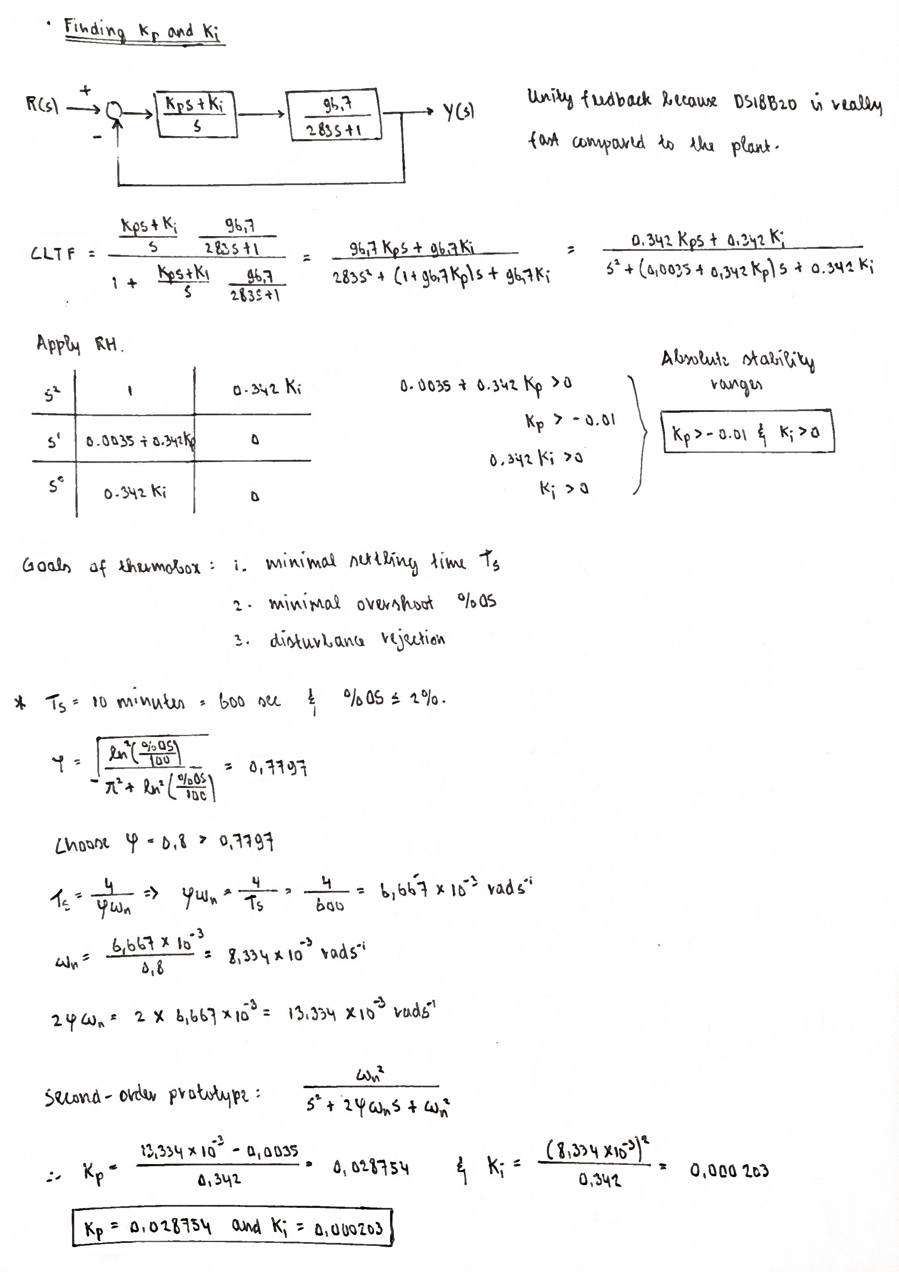
[picture p18: page 1]
