ChrisTekam/thermobox/docs/plant_derivation.pdf

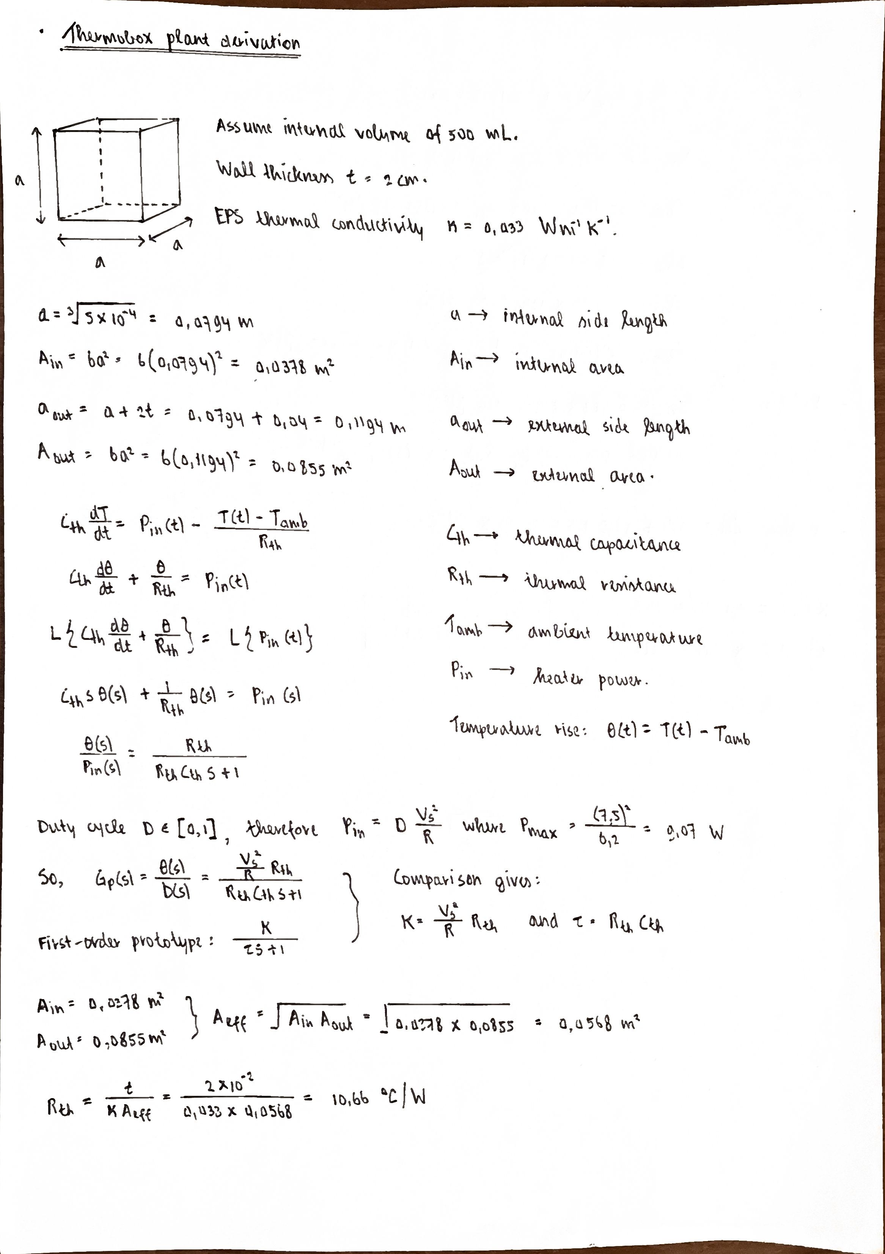
[picture p19: page 1]
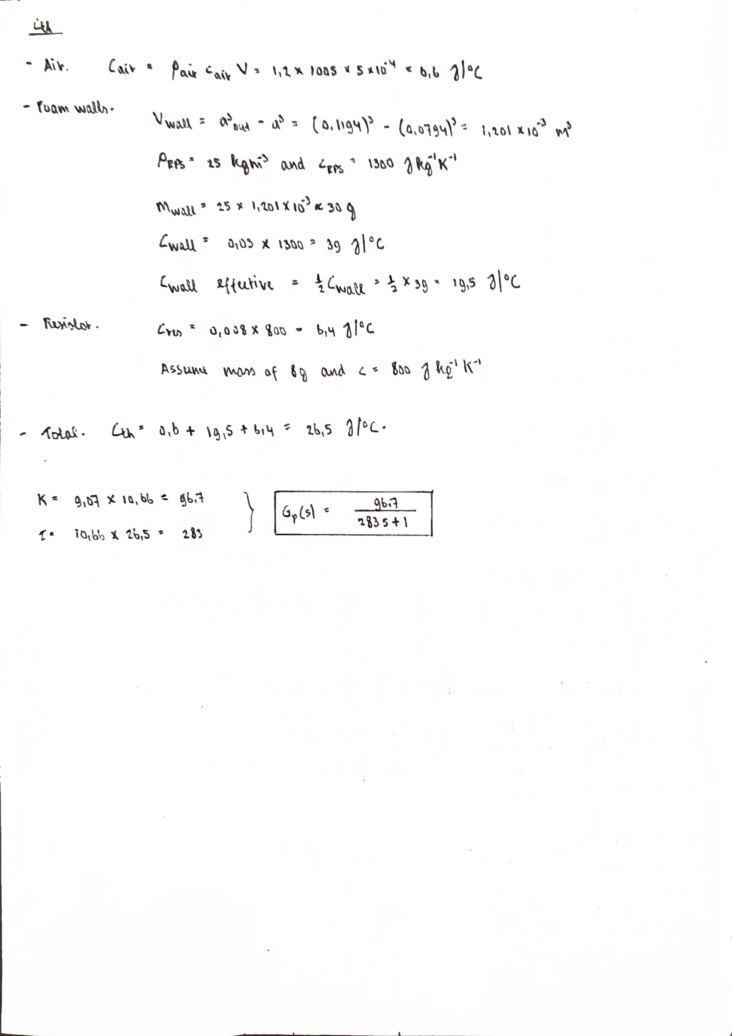
[picture p20: page 2]
