ChrisTekam/thermobox/assets/heater.png

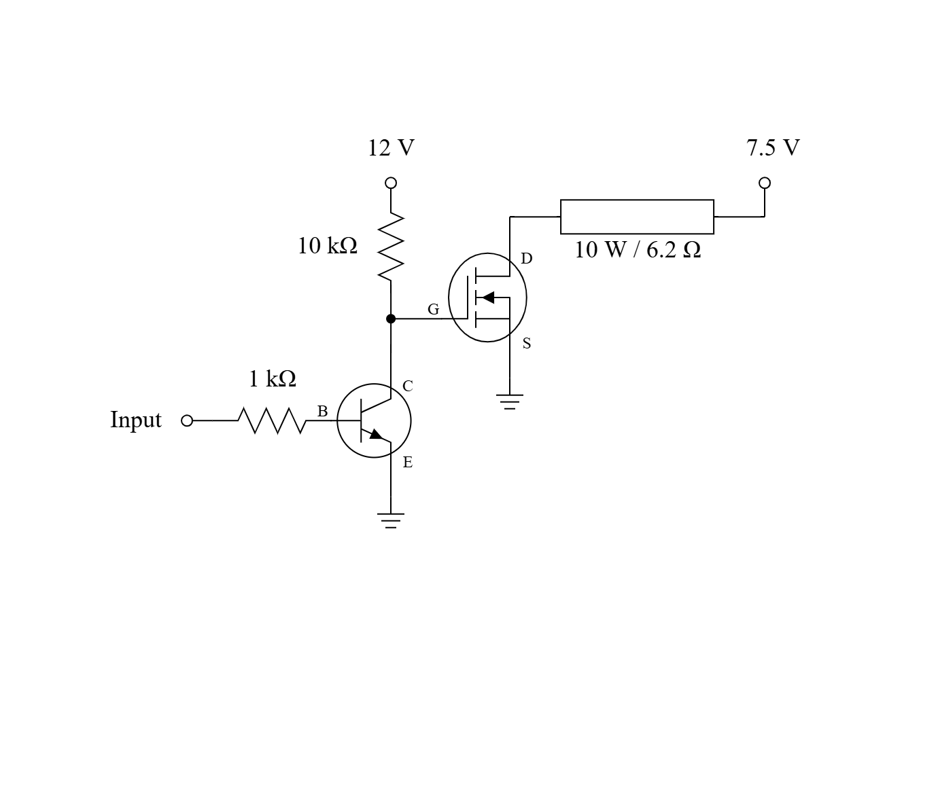
assets/heater.png
