ChrisTekam/thermobox/assets/system_blockdiagram.jpg

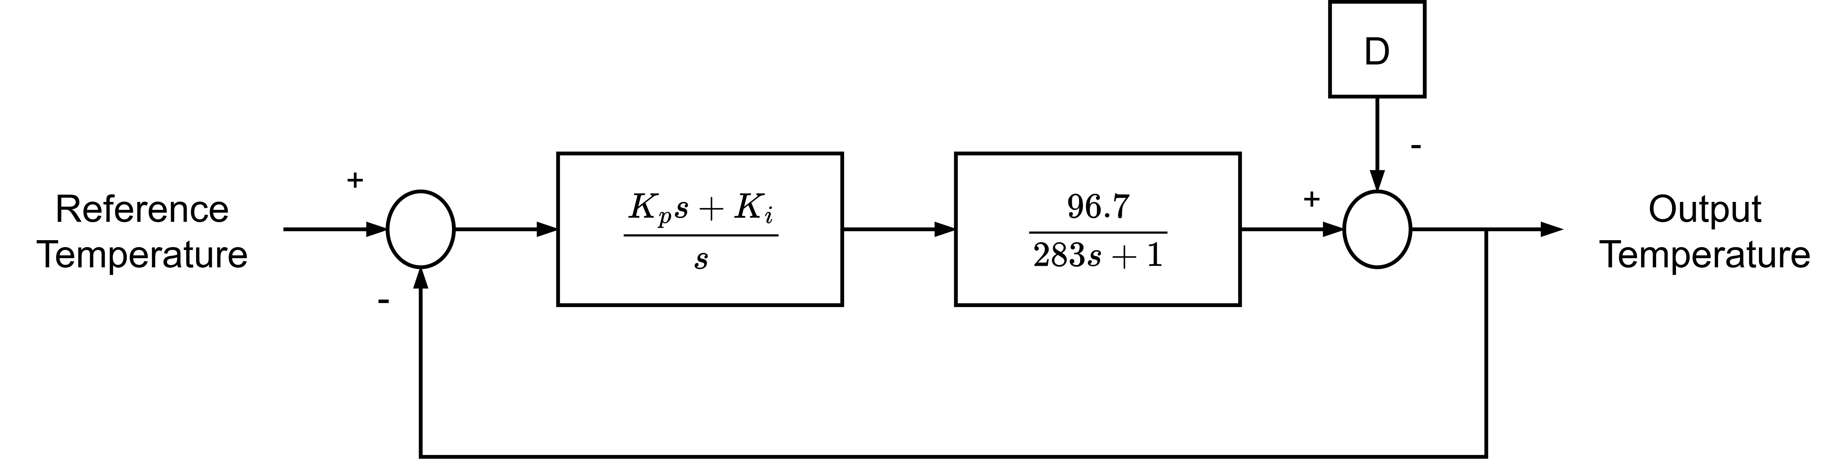
assets/system_blockdiagram.jpg
