ChrisTekam/thermobox/assets/system_blockdiagram.png

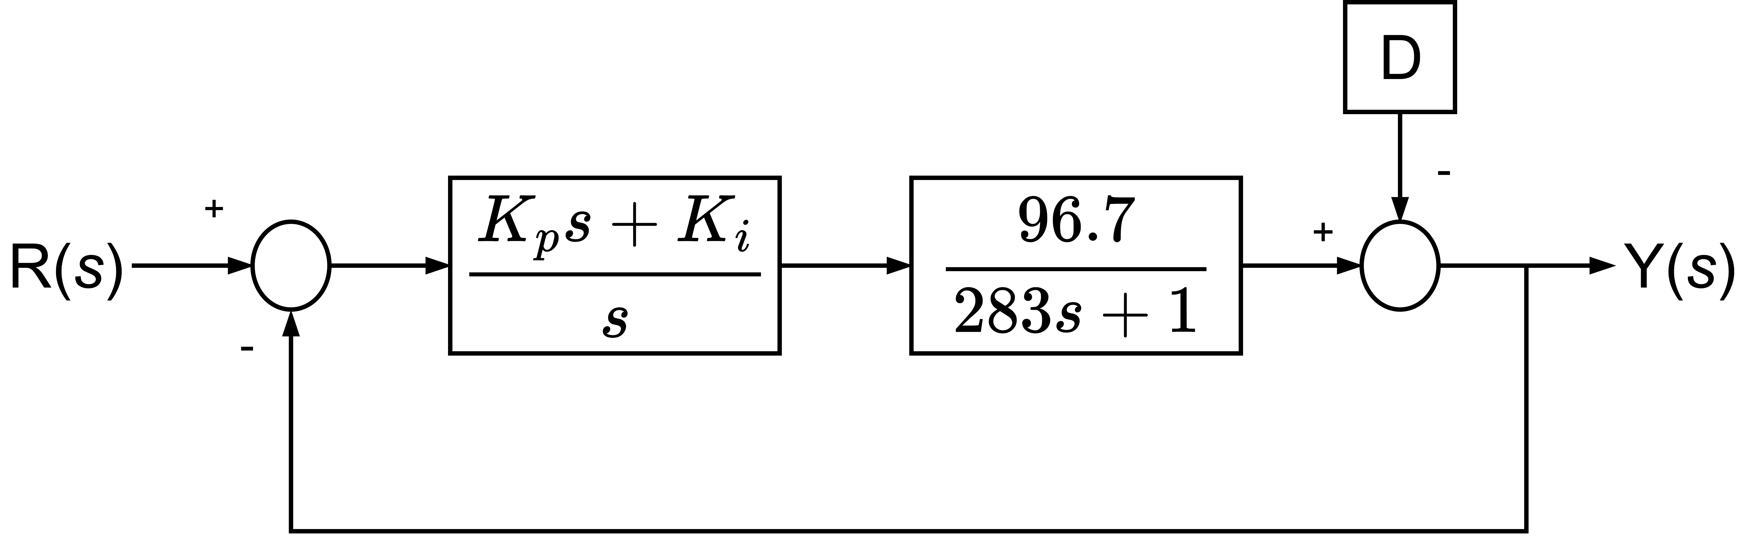
assets/system_blockdiagram.png
