ChrisTekam/thermobox/simulation/bode_magnitude.png

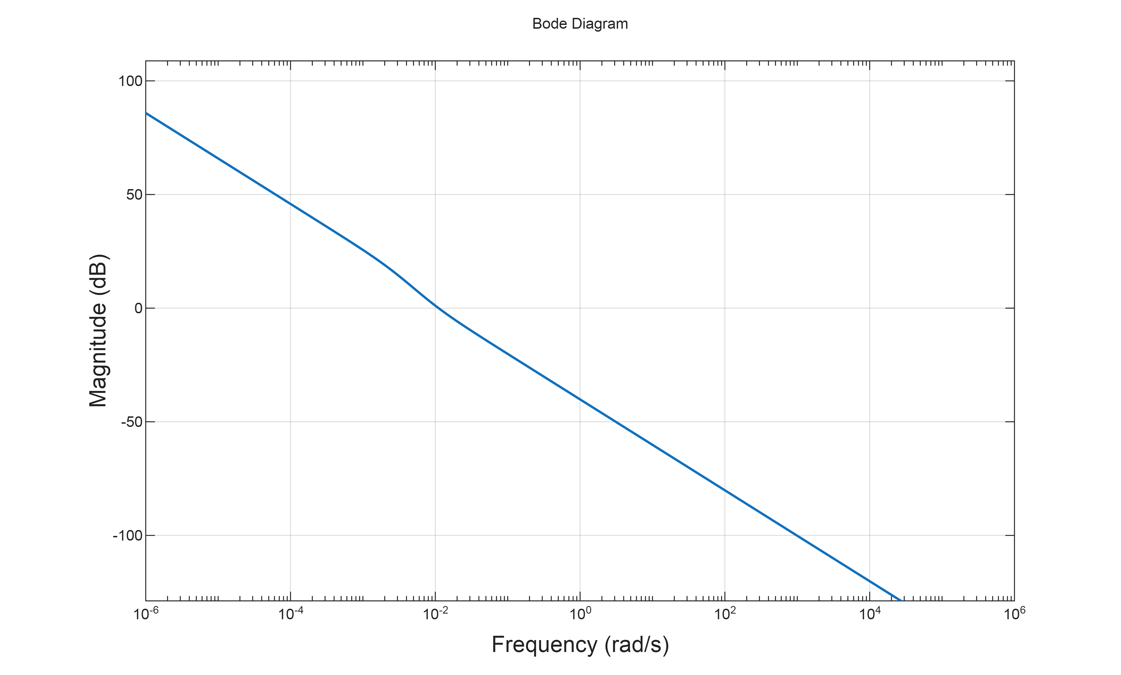
simulation/bode_magnitude.png
