ChrisTekam/thermobox/simulation/bode_phase.png

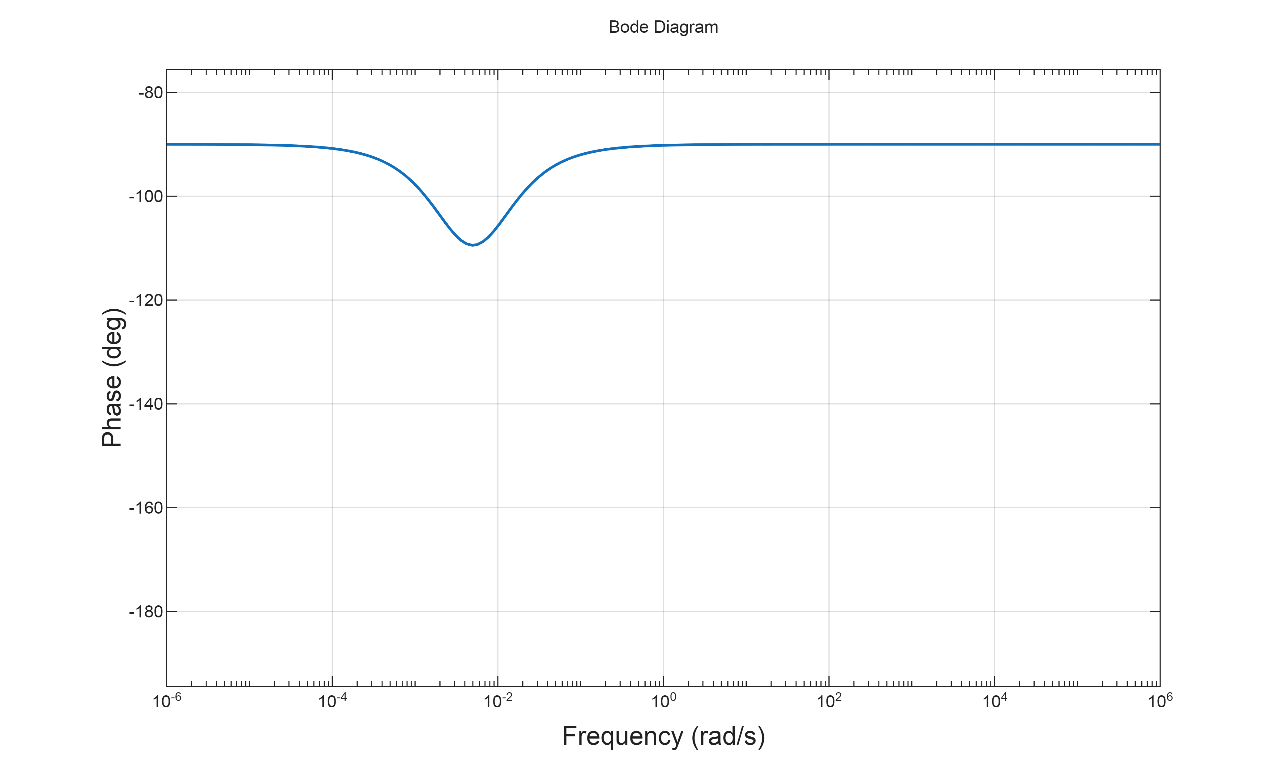
simulation/bode_phase.png
