ChrisTekam/thermobox/simulation/bode_plot.png

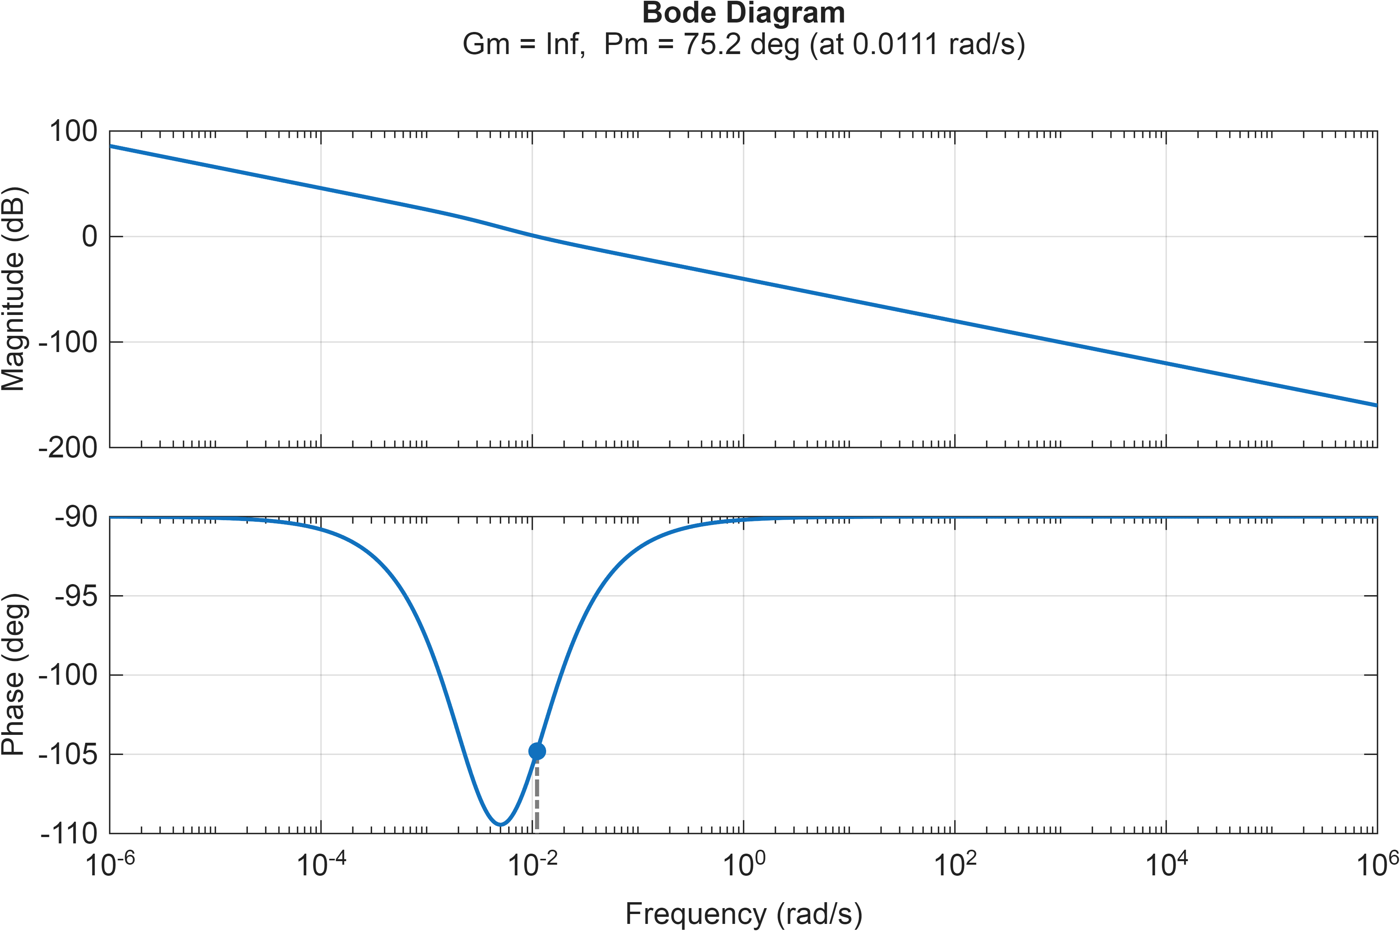
simulation/bode_plot.png
