ChrisTekam/thermobox/simulation/nyquist.png

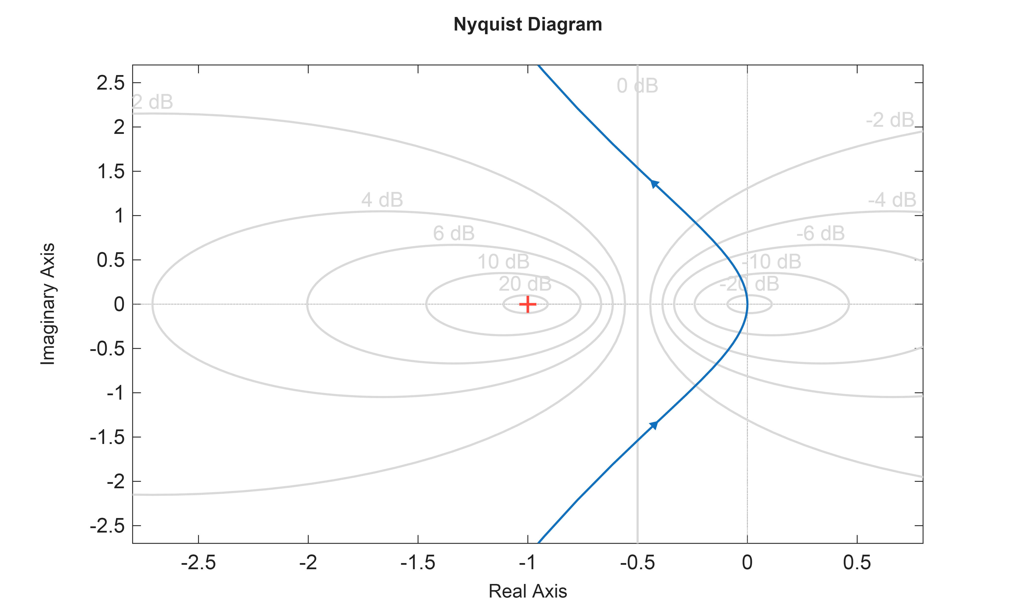
simulation/nyquist.png
