ChrisTekam/thermobox/simulation/pole_zero_locations.png

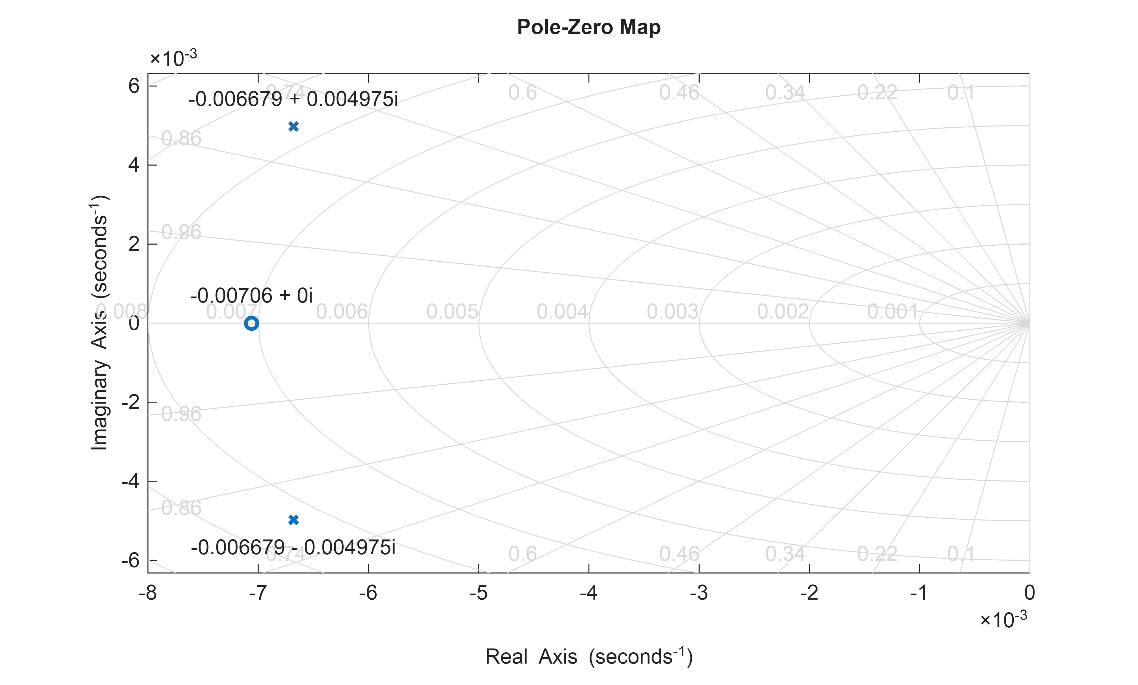
simulation/pole_zero_locations.png
