ChrisTekam/thermobox/simulation/temp_response.png

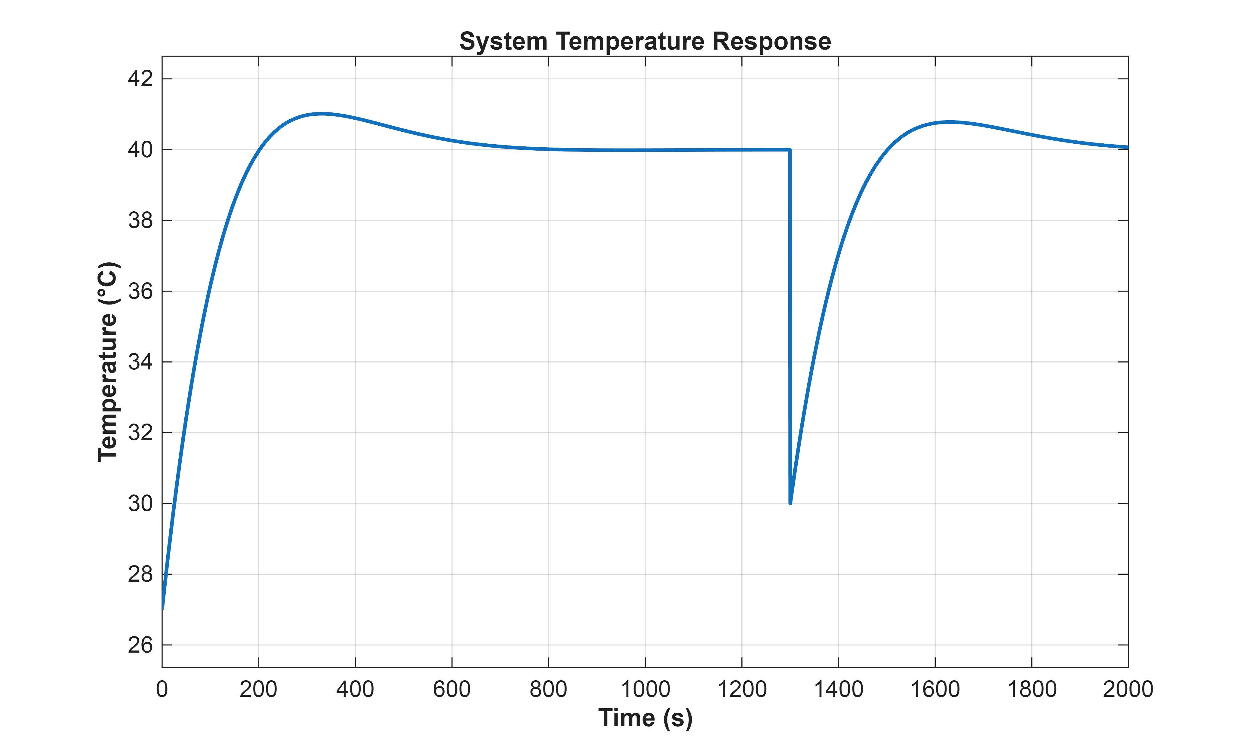
simulation/temp_response.png
