ChrisTekam/thermobox/simulation/time response k_p=0.022257 and k_i=0.000141.png

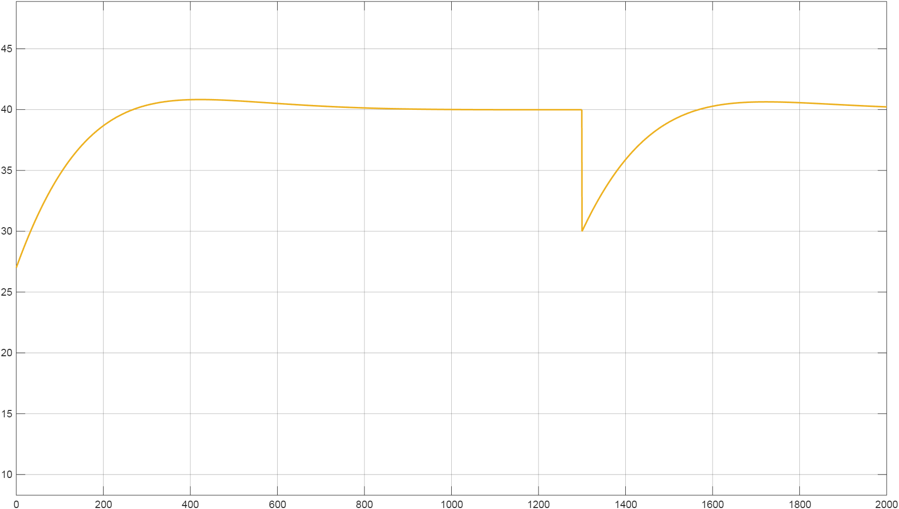
simulation/time response k_p=0.022257 and k_i=0.000141.png
