ChrisTekam/thermobox/tests/open_loop_test/open_loop_test.csv

880 | nan | 26.187 | 0.0 | 255
1880 | nan | 26.187 | 0.0 | 255
2880 | nan | 26.250 | 0.0 | 255
3880 | nan | 26.187 | 0.0 | 255
4880 | nan | 26.250 | 0.0 | 255
5880 | nan | 26.250 | 0.0 | 255
6880 | nan | 26.250 | 0.0 | 255
7880 | nan | 26.250 | 0.0 | 255
8880 | nan | 26.250 | 0.0 | 255
9880 | nan | 26.250 | 0.0 | 255
10880 | nan | 26.250 | 0.0 | 255
11880 | nan | 26.250 | 0.0 | 255
12880 | nan | 26.250 | 0.0 | 255
13880 | nan | 26.250 | 0.0 | 255
14880 | nan | 26.312 | 0.0 | 255
15880 | nan | 26.312 | 0.0 | 255
16880 | nan | 26.312 | 0.0 | 255
17880 | nan | 26.312 | 0.0 | 255
18880 | nan | 26.312 | 0.0 | 255
19880 | nan | 26.312 | 0.0 | 255
20880 | nan | 26.312 | 0.0 | 255
21880 | nan | 26.312 | 0.0 | 255
22880 | nan | 26.312 | 0.0 | 255
23880 | nan | 26.312 | 0.0 | 255
24880 | nan | 26.375 | 0.0 | 255
25880 | nan | 26.375 | 0.0 | 255
26880 | nan | 26.375 | 0.0 | 255
27880 | nan | 26.375 | 0.0 | 255
28880 | nan | 26.375 | 0.0 | 255
29880 | nan | 26.375 | 0.0 | 255
30880 | nan | 26.375 | 100.0 | 0
31880 | nan | 26.375 | 100.0 | 0
32880 | nan | 26.375 | 100.0 | 0
33880 | nan | 26.375 | 100.0 | 0
34880 | nan | 26.437 | 100.0 | 0
35880 | nan | 26.437 | 100.0 | 0
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
