ChrisTekam/thermobox/tests/open_loop_test/OpenloopTest1_29_10_2026.csv

time_s | setpoint | temperature | duty | pwm
0.9 | nan | 27.812 | 0.0 | 255
1.9 | nan | 27.875 | 0.0 | 255
2.9 | nan | 27.875 | 0.0 | 255
3.9 | nan | 27.875 | 0.0 | 255
4.9 | nan | 27.875 | 0.0 | 255
5.9 | nan | 27.937 | 0.0 | 255
6.9 | nan | 27.937 | 0.0 | 255
7.9 | nan | 27.937 | 0.0 | 255
8.9 | nan | 27.937 | 0.0 | 255
9.9 | nan | 27.937 | 0.0 | 255
10.9 | nan | 27.937 | 0.0 | 255
11.9 | nan | 28.000 | 0.0 | 255
12.9 | nan | 28.000 | 0.0 | 255
13.9 | nan | 28.000 | 0.0 | 255
14.9 | nan | 28.000 | 0.0 | 255
15.9 | nan | 28.000 | 0.0 | 255
16.9 | nan | 28.000 | 0.0 | 255
17.9 | nan | 28.062 | 0.0 | 255
18.9 | nan | 28.062 | 0.0 | 255
19.9 | nan | 28.062 | 0.0 | 255
20.9 | nan | 28.062 | 0.0 | 255
21.9 | nan | 28.062 | 0.0 | 255
22.9 | nan | 28.062 | 0.0 | 255
23.9 | nan | 28.125 | 0.0 | 255
24.9 | nan | 28.062 | 0.0 | 255
25.9 | nan | 28.125 | 0.0 | 255
26.9 | nan | 28.125 | 0.0 | 255
27.9 | nan | 28.125 | 0.0 | 255
28.9 | nan | 28.125 | 0.0 | 255
29.9 | nan | 28.125 | 0.0 | 255
30.9 | nan | 28.187 | 100.0 | 0
31.9 | nan | 28.187 | 100.0 | 0
32.9 | nan | 28.187 | 100.0 | 0
33.9 | nan | 28.187 | 100.0 | 0
34.9 | nan | 28.187 | 100.0 | 0
35.9 | nan | 28.187 | 100.0 | 0
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
