ChrisTekam/thermobox/tests/closed loop test/Closedlooptest_29_10_2026.csv

time_s | setpoint | temperature | duty | pwm
1.1 | 40.00 | 29.75 | 0.205 | 203
2.1 | 40.00 | 29.75 | 0.206 | 203
3.1 | 40.00 | 29.75 | 0.206 | 202
4.1 | 40.00 | 29.75 | 0.207 | 202
5.1 | 40.00 | 29.75 | 0.207 | 202
6.1 | 40.00 | 29.75 | 0.207 | 202
7.1 | 40.00 | 29.75 | 0.208 | 202
8.1 | 40.00 | 29.75 | 0.208 | 202
9.1 | 40.00 | 29.75 | 0.209 | 202
10.1 | 40.00 | 29.75 | 0.209 | 202
11.1 | 40.00 | 29.75 | 0.210 | 202
12.1 | 40.00 | 29.69 | 0.211 | 201
13.1 | 40.00 | 29.69 | 0.212 | 201
14.1 | 40.00 | 29.69 | 0.212 | 201
15.1 | 40.00 | 29.69 | 0.212 | 201
16.1 | 40.00 | 29.69 | 0.213 | 201
17.1 | 40.00 | 29.69 | 0.213 | 201
18.1 | 40.00 | 29.69 | 0.214 | 201
19.1 | 40.00 | 29.69 | 0.214 | 200
20.1 | 40.00 | 29.69 | 0.214 | 200
21.1 | 40.00 | 29.69 | 0.215 | 200
22.1 | 40.00 | 29.69 | 0.215 | 200
23.1 | 40.00 | 29.69 | 0.216 | 200
24.1 | 40.00 | 29.62 | 0.217 | 200
25.1 | 40.00 | 29.62 | 0.218 | 199
26.1 | 40.00 | 29.62 | 0.218 | 199
27.1 | 40.00 | 29.62 | 0.219 | 199
28.1 | 40.00 | 29.62 | 0.219 | 199
29.1 | 40.00 | 29.62 | 0.219 | 199
30.1 | 40.00 | 29.62 | 0.220 | 199
31.1 | 40.00 | 29.62 | 0.220 | 199
32.1 | 40.00 | 29.62 | 0.221 | 199
33.1 | 40.00 | 29.62 | 0.221 | 199
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
