ChrisTekam/thermobox/tests/closed loop test/run_20261028_131639.csv

time_s | setpoint | temperature | duty | pwm
1.1 | 40.00 | 27.75 | 0.355 | 165
2.1 | 40.00 | 27.75 | 0.357 | 164
3.1 | 40.00 | 27.75 | 0.360 | 163
4.1 | 40.00 | 27.75 | 0.362 | 163
5.1 | 40.00 | 27.75 | 0.365 | 162
6.1 | 40.00 | 27.75 | 0.367 | 161
7.1 | 40.00 | 27.75 | 0.370 | 161
8.1 | 40.00 | 27.75 | 0.372 | 160
9.1 | 40.00 | 27.81 | 0.373 | 160
10.1 | 40.00 | 27.75 | 0.377 | 159
11.1 | 40.00 | 27.75 | 0.380 | 158
12.1 | 40.00 | 27.75 | 0.382 | 158
13.1 | 40.00 | 27.81 | 0.383 | 157
14.1 | 40.00 | 27.81 | 0.385 | 157
15.1 | 40.00 | 27.75 | 0.389 | 156
16.1 | 40.00 | 27.81 | 0.390 | 156
17.1 | 40.00 | 27.81 | 0.393 | 155
18.1 | 40.00 | 27.81 | 0.395 | 154
19.1 | 40.00 | 27.81 | 0.398 | 154
20.1 | 40.00 | 27.81 | 0.400 | 153
21.1 | 40.00 | 27.75 | 0.404 | 152
22.1 | 40.00 | 27.81 | 0.405 | 152
23.1 | 40.00 | 27.81 | 0.408 | 151
24.1 | 40.00 | 27.81 | 0.410 | 150
25.1 | 40.00 | 27.81 | 0.412 | 150
26.1 | 40.00 | 27.81 | 0.415 | 149
27.1 | 40.00 | 27.81 | 0.417 | 149
28.1 | 40.00 | 27.81 | 0.420 | 148
29.1 | 40.00 | 27.81 | 0.422 | 147
30.1 | 40.00 | 27.81 | 0.425 | 147
31.1 | 40.00 | 27.81 | 0.427 | 146
32.1 | 40.00 | 27.81 | 0.430 | 145
33.1 | 40.00 | 27.81 | 0.432 | 145
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
