ChrisTekam/thermobox/tests/open_loop_test/Open_Loop_test.png

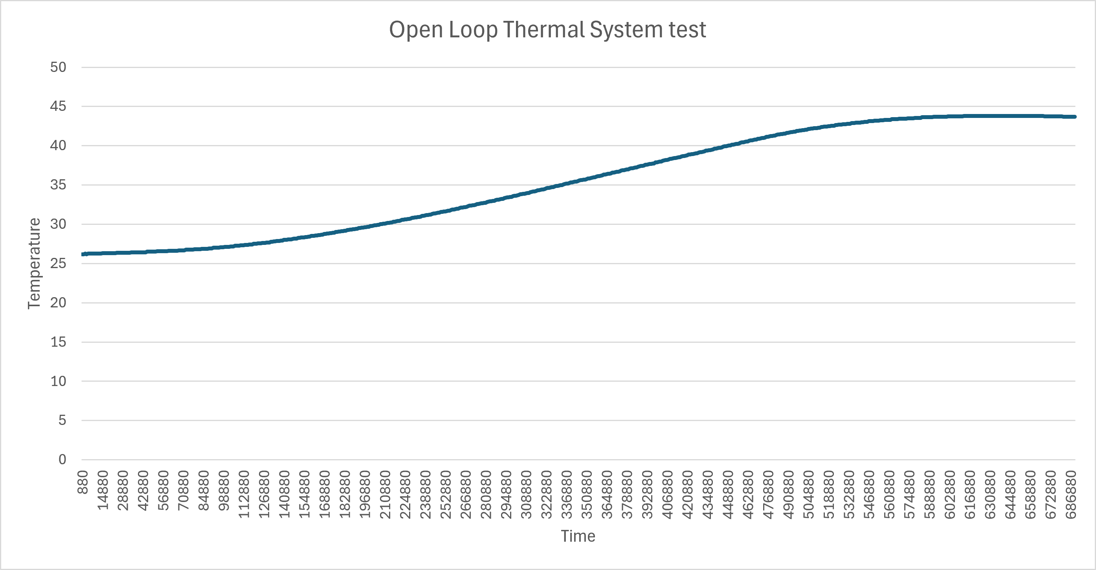
tests/open_loop_test/Open_Loop_test.png
