ChrisTekam/thermobox/assets/thermobox_schematic.pdf

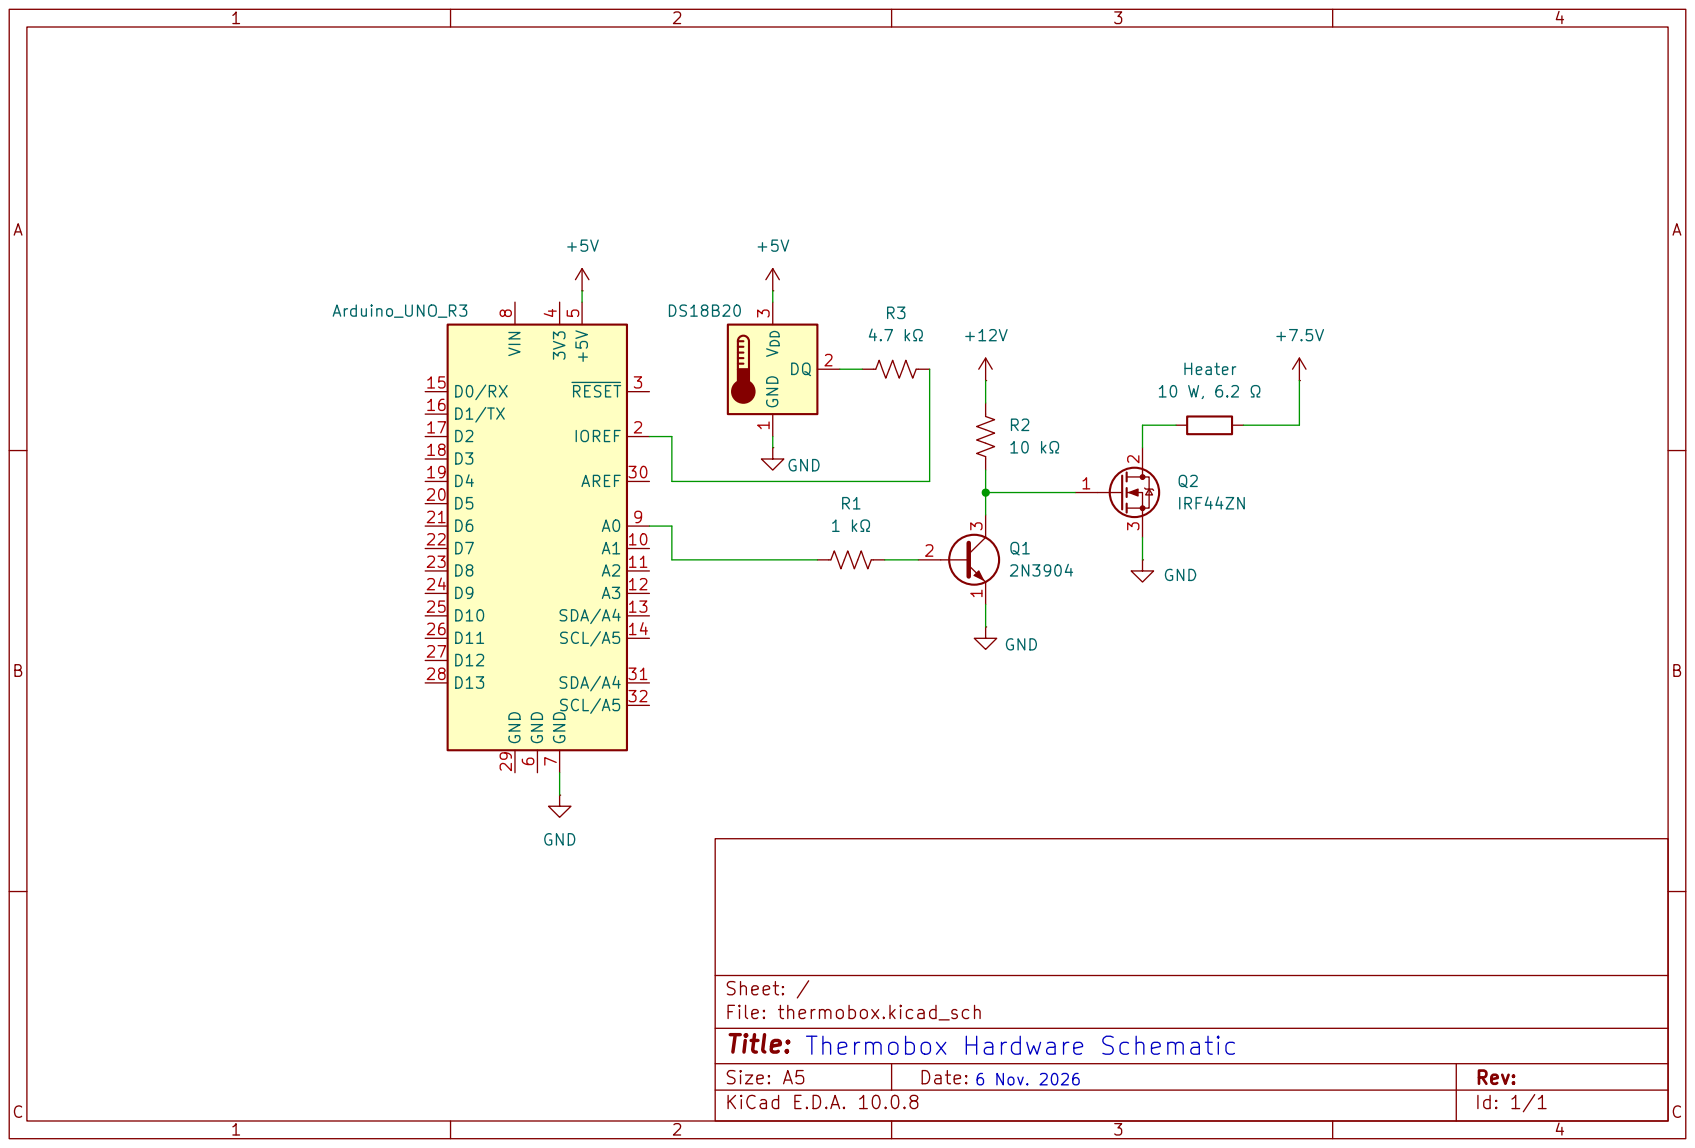
[picture p32: page 1]
