ChrisTekam/thermobox/simulation/thermobox_model.pdf

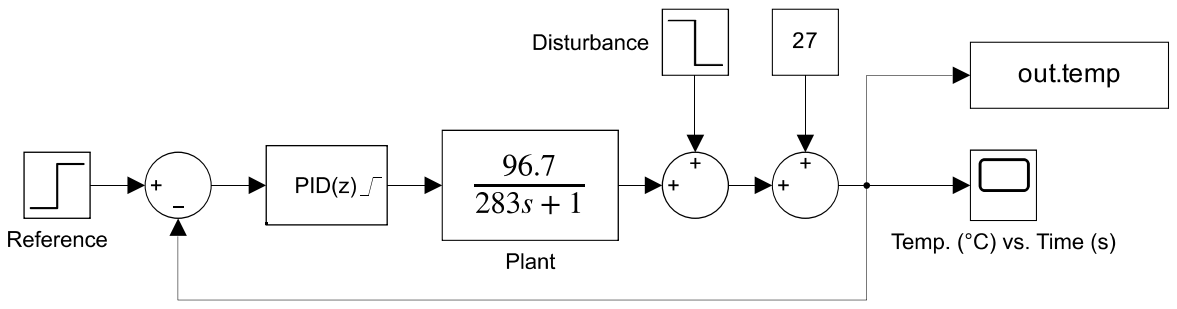
[picture p33: page 1]
