ChrisTekam/thermobox/(commit log)

2026-10-19 Reorganized files to better reflect current structure of the repo.
2026-10-19 Adjusted code with new PI logic and new sample rate (0.5 sec) to better reflect simulation. It was vibecoded, so, unfortunately, the header files were combined with the .cpp files...
2026-10-19 Added heater electrical diagrams
2026-10-25 Open loop response van de Thermobox
    Reference input is op 1 gezet, Feedback loop is weggehaald. En de ice block disturbance is weggehaald.
2026-10-26 Replace includes with updated sensor and controller files
2026-10-26 plant derivation for assumption of 500 ml box
2026-10-30 Plant 38.7/(125316s² + 708s + 1)
    Met de Kp = 0.029772 en Ki = 5.04387e-05
2026-10-30 PI design voor plant 38.7/(125316s² + 708s + 1)
    Dit genereert de nieuwe Kp en Ki waarden. omega_c en Gm zijn constante waarden (check t nader)
